Jed0vcela/OPL-synth/schematics, board/opl3 synth EAGLE/SVCSYNTH00.csv

Part | Value | Device | Package | Description | ARROW_PART_NUMBER | ARROW_PRICE-STOCK | DESCRIPTION | HEIGHT | MANUFACTURER_NAME | MANUFACTURER_PART_NUMBER | MF | MOUSER_PART_NUMBER | MOUSER_PRICE-STOCK | MPN | OC_FARNELL | OC_NEWARK | POPULARITY | SPICEPREFIX
A1 | PICO | PICO | PICO | RP2040 microcontroller chip designed by Raspberry Pi in the United Kingdom 2 SPI, 2 I2C, 2 UART, 3 12-bit ADC, 16 controllable PWM channels |  |  | RP2040 microcontroller chip designed by Raspberry Pi in the United Kingdom 2 SPI, 2 I2C, 2 UART, 3 12-bit ADC, 16 controllable PWM channels | 1mm | RASPBERRY-PI | PICO
A2 | 74LS14D | 74LS14D | SO14 | Hex schmitt trigger INVERTER |  |  |  |  |  |  |  |  |  |  |  |  | 3
A3 | 7805DT | 7805DT | TO252 | Positive VOLTAGE REGULATOR |  |  |  |  |  |  |  |  |  |  |  |  | 0
A4 | 74LS14D | 74LS14D | SO14 | Hex schmitt trigger INVERTER |  |  |  |  |  |  |  |  |  |  |  |  | 3
A5 | 74LS14D | 74LS14D | SO14 | Hex schmitt trigger INVERTER |  |  |  |  |  |  |  |  |  |  |  |  | 3
A6 | 74HC595D | 74HC595D | SO16 | 8-bit SHIFT REGISTER, output latch |  |  |  |  |  |  |  |  |  |  |  |  | 21
A7 | YMF262-M | YMF262-M | SOIC127P1180X250-24N | SOUND GENERATOR CIRCUIT, 24 Pin, SOP |  |  | SOUND GENERATOR CIRCUIT, 24 Pin, SOP | 2.5mm | Yamaha | YMF262-M
A8 | YAC512-M | YAC512-M | SOIC127P780X230-16N | Digital Analog Converter, Single, 16 Bit, 16 Pin, SOP |  |  | Digital Analog Converter, Single, 16 Bit, 16 Pin, SOP | 2.3mm | Yamaha | YAC512-M
A9 | YAC512-M | YAC512-M | SOIC127P780X230-16N | Digital Analog Converter, Single, 16 Bit, 16 Pin, SOP |  |  | Digital Analog Converter, Single, 16 Bit, 16 Pin, SOP | 2.3mm | Yamaha | YAC512-M
A10 | RC4580 | LM1458D | SO08 | OP AMP |  |  |  |  |  |  |  |  |  |  |  |  | 1
A11 | RC4580 | LM1458D | SO08 | OP AMP |  |  |  |  |  |  |  |  |  |  |  |  | 1
A12 | RC4580 | LM1458D | SO08 | OP AMP |  |  |  |  |  |  |  |  |  |  |  |  | 1
A13 | RC4580 | LM1458D | SO08 | OP AMP |  |  |  |  |  |  |  |  |  |  |  |  | 1
A14 | 74HC595D | 74HC595D | SO16 | 8-bit SHIFT REGISTER, output latch |  |  |  |  |  |  |  |  |  |  |  |  | 21
A15 | YMF262-M | YMF262-M | SOIC127P1180X250-24N | SOUND GENERATOR CIRCUIT, 24 Pin, SOP |  |  | SOUND GENERATOR CIRCUIT, 24 Pin, SOP | 2.5mm | Yamaha | YMF262-M
A16 | YAC512-M | YAC512-M | SOIC127P780X230-16N | Digital Analog Converter, Single, 16 Bit, 16 Pin, SOP |  |  | Digital Analog Converter, Single, 16 Bit, 16 Pin, SOP | 2.3mm | Yamaha | YAC512-M
A17 | YAC512-M | YAC512-M | SOIC127P780X230-16N | Digital Analog Converter, Single, 16 Bit, 16 Pin, SOP |  |  | Digital Analog Converter, Single, 16 Bit, 16 Pin, SOP | 2.3mm | Yamaha | YAC512-M
A18 | RC4580 | LM1458D | SO08 | OP AMP |  |  |  |  |  |  |  |  |  |  |  |  | 1
A19 | RC4580 | LM1458D | SO08 | OP AMP |  |  |  |  |  |  |  |  |  |  |  |  | 1
A20 | RC4580 | LM1458D | SO08 | OP AMP |  |  |  |  |  |  |  |  |  |  |  |  | 1
A21 | RC4580 | LM1458D | SO08 | OP AMP |  |  |  |  |  |  |  |  |  |  |  |  | 1
A22 | LM1458D | LM1458D | SO08 | OP AMP |  |  |  |  |  |  |  |  |  |  |  |  | 1
A23 | 74LS165D | 74LS165D | SO16 | 8-bit parallel load SHIFT REGISTER |  |  |  |  |  |  |  |  |  |  |  |  | 3
A24 | 74LS165D | 74LS165D | SO16 | 8-bit parallel load SHIFT REGISTER |  |  |  |  |  |  |  |  |  |  |  |  | 3
A25 | 4051D | 4051D | SO16 | 8-channel ANALOG MULTIPLEXER |  |  |  |  |  |  |  |  |  |  |  |  | 5
A26 | 4051D | 4051D | SO16 | 8-channel ANALOG MULTIPLEXER |  |  |  |  |  |  |  |  |  |  |  |  | 5
A27 | 4051D | 4051D | SO16 | 8-channel ANALOG MULTIPLEXER |  |  |  |  |  |  |  |  |  |  |  |  | 5
A28 | LM2903D | LM2903D | SO08 | COMPARATOR |  |  |  |  |  |  |  |  |  |  |  |  | 0
A29 | 74AHC1G14DBV | 74AHC1G14DBV | SOT23-5 | Single Schmitt-Trigger Inverter Gate
C1 | 2n7 | C0805 | R0805 | SMD Sizes:
C2 | 2n7 | C0805 | R0805 | SMD Sizes:
C3 | 2n7 | C0805 | R0805 | SMD Sizes:
C4 | 2n7 | C0805 | R0805 | SMD Sizes:
C5 | 2n7 | C0805 | R0805 | SMD Sizes:
C6 | 2n7 | C0805 | R0805 | SMD Sizes:
C7 | 2n7 | C0805 | R0805 | SMD Sizes:
C8 | 2n7 | C0805 | R0805 | SMD Sizes:
C9 | 2n7 | C0805 | R0805 | SMD Sizes:
C10 | 2n7 | C0805 | R0805 | SMD Sizes:
C11 | 2n7 | C0805 | R0805 | SMD Sizes:
C12 | 2n7 | C0805 | R0805 | SMD Sizes:
C13 | 2n7 | C0805 | R0805 | SMD Sizes:
C14 | 2n7 | C0805 | R0805 | SMD Sizes:
C15 | 2n7 | C0805 | R0805 | SMD Sizes:
C16 | 2n7 | C0805 | R0805 | SMD Sizes:
C17 | 100n | C0805 | R0805 | SMD Sizes:
C18 | 100n | C0805 | R0805 | SMD Sizes:
C19 | 100n | C0805 | R0805 | SMD Sizes:
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
L8 |  | LED3MM | LED3MM | LED
L9 |  | LED3MM | LED3MM | LED
L10 |  | LED3MM | LED3MM | LED
L11 |  | LED3MM | LED3MM | LED
L12 |  | LED3MM | LED3MM | LED
M1 | MIDIJACK | MIDIJACK | CP-2350 | DIN 5 jack also known as MIDI jack
M2 | MIDIJACK | MIDIJACK | CP-2350 | DIN 5 jack also known as MIDI jack
OK1 | PC817 | PC817 | DIL04 | SHARP OPTO COUPLER |  |  |  |  |  |  |  |  |  | PC817X4J000F | 9707727 | 97K7059 | 20
P1 | 10k | TRIM_EU-CA6V | CA6V | POTENTIOMETER |  |  |  |  |  |  |  |  |  |  |  |  | 10
P2 | 10k | TRIM_EU-CA6V | CA6V | POTENTIOMETER |  |  |  |  |  |  |  |  |  |  |  |  | 10
P3 | 10k | TRIM_EU-CA6V | CA6V | POTENTIOMETER |  |  |  |  |  |  |  |  |  |  |  |  | 10
P4 | 10k | TRIM_EU-CA6V | CA6V | POTENTIOMETER |  |  |  |  |  |  |  |  |  |  |  |  | 10
P6 | 10k | TRIM_EU-CA6V | CA6V | POTENTIOMETER |  |  |  |  |  |  |  |  |  |  |  |  | 10
P8 | 10k | TRIM_EU-CA6V | CA6V | POTENTIOMETER |  |  |  |  |  |  |  |  |  |  |  |  | 10
P10 | 10k | TRIM_EU-CA6V | CA6V | POTENTIOMETER |  |  |  |  |  |  |  |  |  |  |  |  | 10
Q1 | TEFT4300 | TEFT4300 | TEFT4300 | Vishay TEFT4300 60 Infrared Phototransistor, Through-hole 3mm Package | TEFT4300 | https://www.arrow.com/en/products/teft4300/vishay?region=nac | Vishay TEFT4300 60 Infrared Phototransistor, Through-hole 3mm Package | 6.1mm | Vishay | TEFT4300 |  | 782-TEFT4300 | https://www.mouser.co.uk/ProductDetail/Vishay-Semiconductors/TEFT4300?qs=HsFHTXumnCRbcrt8oPFPMA%3D%3D
Q2 | TEFT4300 | TEFT4300 | TEFT4300 | Vishay TEFT4300 60 Infrared Phototransistor, Through-hole 3mm Package | TEFT4300 | https://www.arrow.com/en/products/teft4300/vishay?region=nac | Vishay TEFT4300 60 Infrared Phototransistor, Through-hole 3mm Package | 6.1mm | Vishay | TEFT4300 |  | 782-TEFT4300 | https://www.mouser.co.uk/ProductDetail/Vishay-Semiconductors/TEFT4300?qs=HsFHTXumnCRbcrt8oPFPMA%3D%3D
Q3 | TEFT4300 | TEFT4300 | TEFT4300 | Vishay TEFT4300 60 Infrared Phototransistor, Through-hole 3mm Package | TEFT4300 | https://www.arrow.com/en/products/teft4300/vishay?region=nac | Vishay TEFT4300 60 Infrared Phototransistor, Through-hole 3mm Package | 6.1mm | Vishay | TEFT4300 |  | 782-TEFT4300 | https://www.mouser.co.uk/ProductDetail/Vishay-Semiconductors/TEFT4300?qs=HsFHTXumnCRbcrt8oPFPMA%3D%3D
Q4 | TEFT4300 | TEFT4300 | TEFT4300 | Vishay TEFT4300 60 Infrared Phototransistor, Through-hole 3mm Package | TEFT4300 | https://www.arrow.com/en/products/teft4300/vishay?region=nac | Vishay TEFT4300 60 Infrared Phototransistor, Through-hole 3mm Package | 6.1mm | Vishay | TEFT4300 |  | 782-TEFT4300 | https://www.mouser.co.uk/ProductDetail/Vishay-Semiconductors/TEFT4300?qs=HsFHTXumnCRbcrt8oPFPMA%3D%3D
Q5 | TEFT4300 | TEFT4300 | TEFT4300 | Vishay TEFT4300 60 Infrared Phototransistor, Through-hole 3mm Package | TEFT4300 | https://www.arrow.com/en/products/teft4300/vishay?region=nac | Vishay TEFT4300 60 Infrared Phototransistor, Through-hole 3mm Package | 6.1mm | Vishay | TEFT4300 |  | 782-TEFT4300 | https://www.mouser.co.uk/ProductDetail/Vishay-Semiconductors/TEFT4300?qs=HsFHTXumnCRbcrt8oPFPMA%3D%3D
Q6 | TEFT4300 | TEFT4300 | TEFT4300 | Vishay TEFT4300 60 Infrared Phototransistor, Through-hole 3mm Package | TEFT4300 | https://www.arrow.com/en/products/teft4300/vishay?region=nac | Vishay TEFT4300 60 Infrared Phototransistor, Through-hole 3mm Package | 6.1mm | Vishay | TEFT4300 |  | 782-TEFT4300 | https://www.mouser.co.uk/ProductDetail/Vishay-Semiconductors/TEFT4300?qs=HsFHTXumnCRbcrt8oPFPMA%3D%3D
Q7 | TEFT4300 | TEFT4300 | TEFT4300 | Vishay TEFT4300 60 Infrared Phototransistor, Through-hole 3mm Package | TEFT4300 | https://www.arrow.com/en/products/teft4300/vishay?region=nac | Vishay TEFT4300 60 Infrared Phototransistor, Through-hole 3mm Package | 6.1mm | Vishay | TEFT4300 |  | 782-TEFT4300 | https://www.mouser.co.uk/ProductDetail/Vishay-Semiconductors/TEFT4300?qs=HsFHTXumnCRbcrt8oPFPMA%3D%3D
Q8 | TEFT4300 | TEFT4300 | TEFT4300 | Vishay TEFT4300 60 Infrared Phototransistor, Through-hole 3mm Package | TEFT4300 | https://www.arrow.com/en/products/teft4300/vishay?region=nac | Vishay TEFT4300 60 Infrared Phototransistor, Through-hole 3mm Package | 6.1mm | Vishay | TEFT4300 |  | 782-TEFT4300 | https://www.mouser.co.uk/ProductDetail/Vishay-Semiconductors/TEFT4300?qs=HsFHTXumnCRbcrt8oPFPMA%3D%3D
Q9 | TEFT4300 | TEFT4300 | TEFT4300 | Vishay TEFT4300 60 Infrared Phototransistor, Through-hole 3mm Package | TEFT4300 | https://www.arrow.com/en/products/teft4300/vishay?region=nac | Vishay TEFT4300 60 Infrared Phototransistor, Through-hole 3mm Package | 6.1mm | Vishay | TEFT4300 |  | 782-TEFT4300 | https://www.mouser.co.uk/ProductDetail/Vishay-Semiconductors/TEFT4300?qs=HsFHTXumnCRbcrt8oPFPMA%3D%3D
Q10 | TEFT4300 | TEFT4300 | TEFT4300 | Vishay TEFT4300 60 Infrared Phototransistor, Through-hole 3mm Package | TEFT4300 | https://www.arrow.com/en/products/teft4300/vishay?region=nac | Vishay TEFT4300 60 Infrared Phototransistor, Through-hole 3mm Package | 6.1mm | Vishay | TEFT4300 |  | 782-TEFT4300 | https://www.mouser.co.uk/ProductDetail/Vishay-Semiconductors/TEFT4300?qs=HsFHTXumnCRbcrt8oPFPMA%3D%3D
Q11 | TEFT4300 | TEFT4300 | TEFT4300 | Vishay TEFT4300 60 Infrared Phototransistor, Through-hole 3mm Package | TEFT4300 | https://www.arrow.com/en/products/teft4300/vishay?region=nac | Vishay TEFT4300 60 Infrared Phototransistor, Through-hole 3mm Package | 6.1mm | Vishay | TEFT4300 |  | 782-TEFT4300 | https://www.mouser.co.uk/ProductDetail/Vishay-Semiconductors/TEFT4300?qs=HsFHTXumnCRbcrt8oPFPMA%3D%3D
Q12 | TEFT4300 | TEFT4300 | TEFT4300 | Vishay TEFT4300 60 Infrared Phototransistor, Through-hole 3mm Package | TEFT4300 | https://www.arrow.com/en/products/teft4300/vishay?region=nac | Vishay TEFT4300 60 Infrared Phototransistor, Through-hole 3mm Package | 6.1mm | Vishay | TEFT4300 |  | 782-TEFT4300 | https://www.mouser.co.uk/ProductDetail/Vishay-Semiconductors/TEFT4300?qs=HsFHTXumnCRbcrt8oPFPMA%3D%3D
Q13 | 14.31818M-SMDHC49S | CSM-7X-DU | CSM-7X-DU | SMD CRYSTAL |  |  |  |  |  |  |  |  |  |  | unknown | unknown | 3
R1 | 10k | R0805 | R0805 | Resistor vcetne SMD
R2 | 10k | R0805 | R0805 | Resistor vcetne SMD
R3 | 10k | R0805 | R0805 | Resistor vcetne SMD
R4 | 10k | R0805 | R0805 | Resistor vcetne SMD
R5 | 10k | R0805 | R0805 | Resistor vcetne SMD
R6 | 10k | R0805 | R0805 | Resistor vcetne SMD
R7 | 10k | R0805 | R0805 | Resistor vcetne SMD
R8 | 10k | R0805 | R0805 | Resistor vcetne SMD
R9 | 10k | R0805 | R0805 | Resistor vcetne SMD
R10 | 10k | R0805 | R0805 | Resistor vcetne SMD
R11 | 10k | R0805 | R0805 | Resistor vcetne SMD
R12 | 10k | R0805 | R0805 | Resistor vcetne SMD
R13 | 10k | R0805 | R0805 | Resistor vcetne SMD
R14 | 10k | R0805 | R0805 | Resistor vcetne SMD
R15 | 10k | R0805 | R0805 | Resistor vcetne SMD
R16 | 10k | R0805 | R0805 | Resistor vcetne SMD
R17 | 33 | R0805 | R0805 | Resistor vcetne SMD
R18 | 10k | TRIM_EU-CA6V | CA6V | POTENTIOMETER |  |  |  |  |  |  |  |  |  |  |  |  | 10
R19 | 10k | R0805 | R0805 | Resistor vcetne SMD
R20 | 4k7 | R0805 | R0805 | Resistor vcetne SMD
R21 | 100 | R0805 | R0805 | Resistor vcetne SMD
R22 | 4k7 | R0805 | R0805 | Resistor vcetne SMD
R23 | 100 | R0805 | R0805 | Resistor vcetne SMD
R24 | 10k | R0805 | R0805 | Resistor vcetne SMD
R25 | 10k | TRIM_EU-CA6V | CA6V | POTENTIOMETER |  |  |  |  |  |  |  |  |  |  |  |  | 10
R26 | 4k7 | R0805 | R0805 | Resistor vcetne SMD
R27 | 4k7 | R0805 | R0805 | Resistor vcetne SMD
R28 | 100 | R0805 | R0805 | Resistor vcetne SMD
R29 | 100 | R0805 | R0805 | Resistor vcetne SMD
R30 | 1k | R0805 | R0805 | Resistor vcetne SMD
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
X1 | STEREOJACK | STEREOJACK | STX3100 | MIC/HEADPHONE JACK
