Jed0vcela/OPL-synth/3D models/body v2.STEP

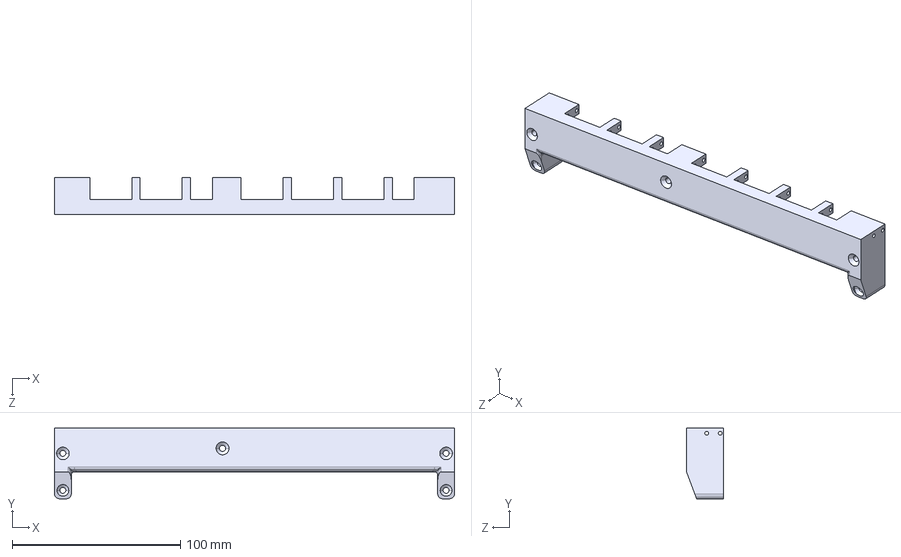
[picture p1: CAD file, 2025-05-17]
3D models/body v2.STEP
238.0 x 42.0 x 22.0 mm
