Jed0vcela/OPL-synth/3D models/white key 2.STEP

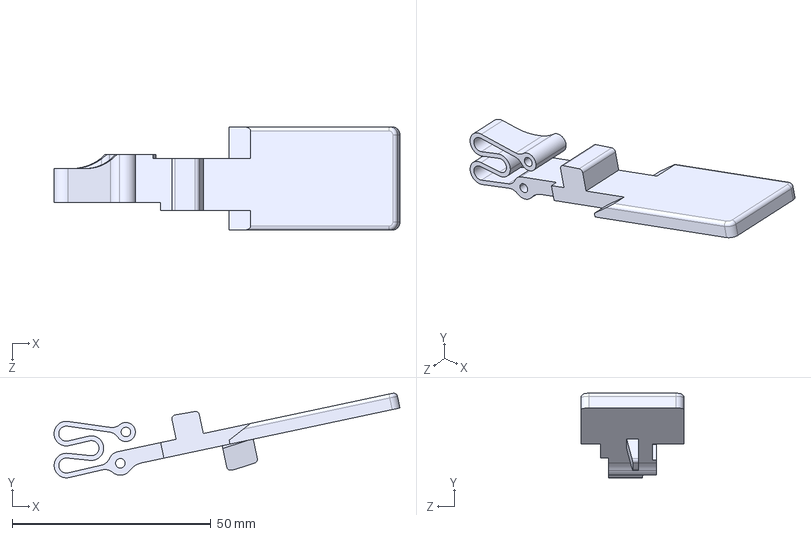
[picture p2: CAD file, 2025-05-17]
3D models/white key 2.STEP
87.1 x 21.3 x 26.0 mm
