Jed0vcela/OPL-synth/3D models/spodni deska v3.STEP

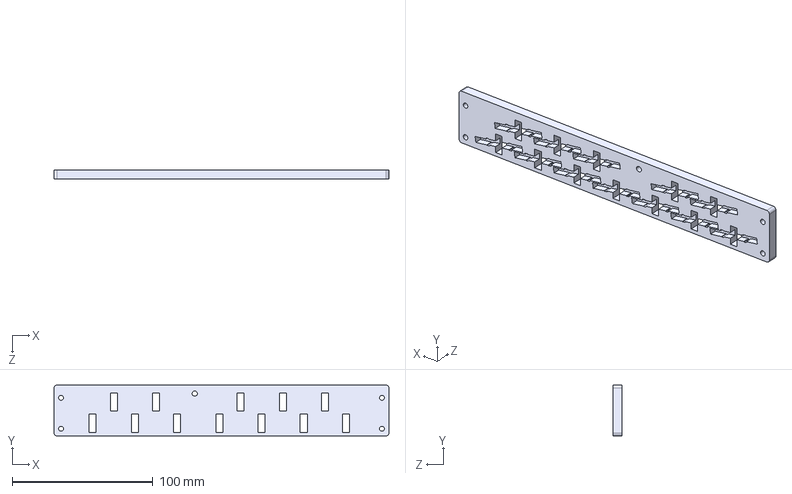
[picture p3: CAD file, 2025-05-17]
3D models/spodni deska v3.STEP
238.0 x 36.0 x 6.50 mm
