Jed0vcela/OPL-synth/3D models/black key 2.STEP

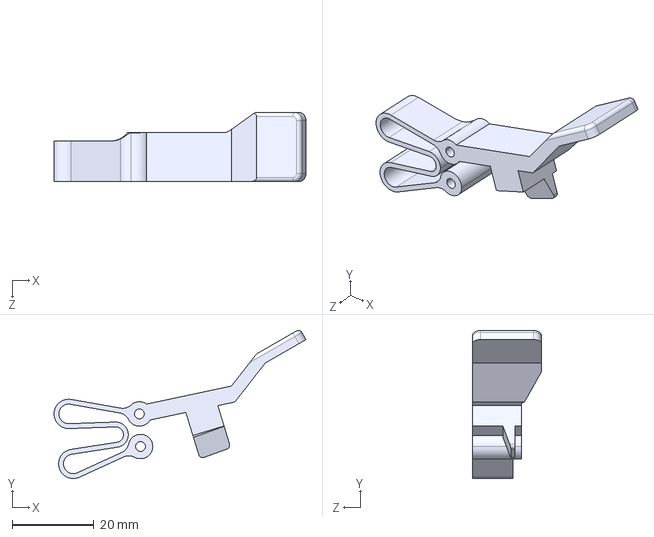
[picture p4: CAD file, 2025-05-17]
3D models/black key 2.STEP
61.8 x 36.3 x 17.0 mm
