Jed0vcela/OPL-synth/(list of files, cad)

Other CAD files:
3D models/black key 2.SLDPRT
3D models/black key 2.STL
3D models/spodni deska v3.STL
3D models/white key 2.SLDPRT
3D models/white key 2.STL
