Jed0vcela/OPL-synth/schematics, board/SVCSYNTH00.pdf

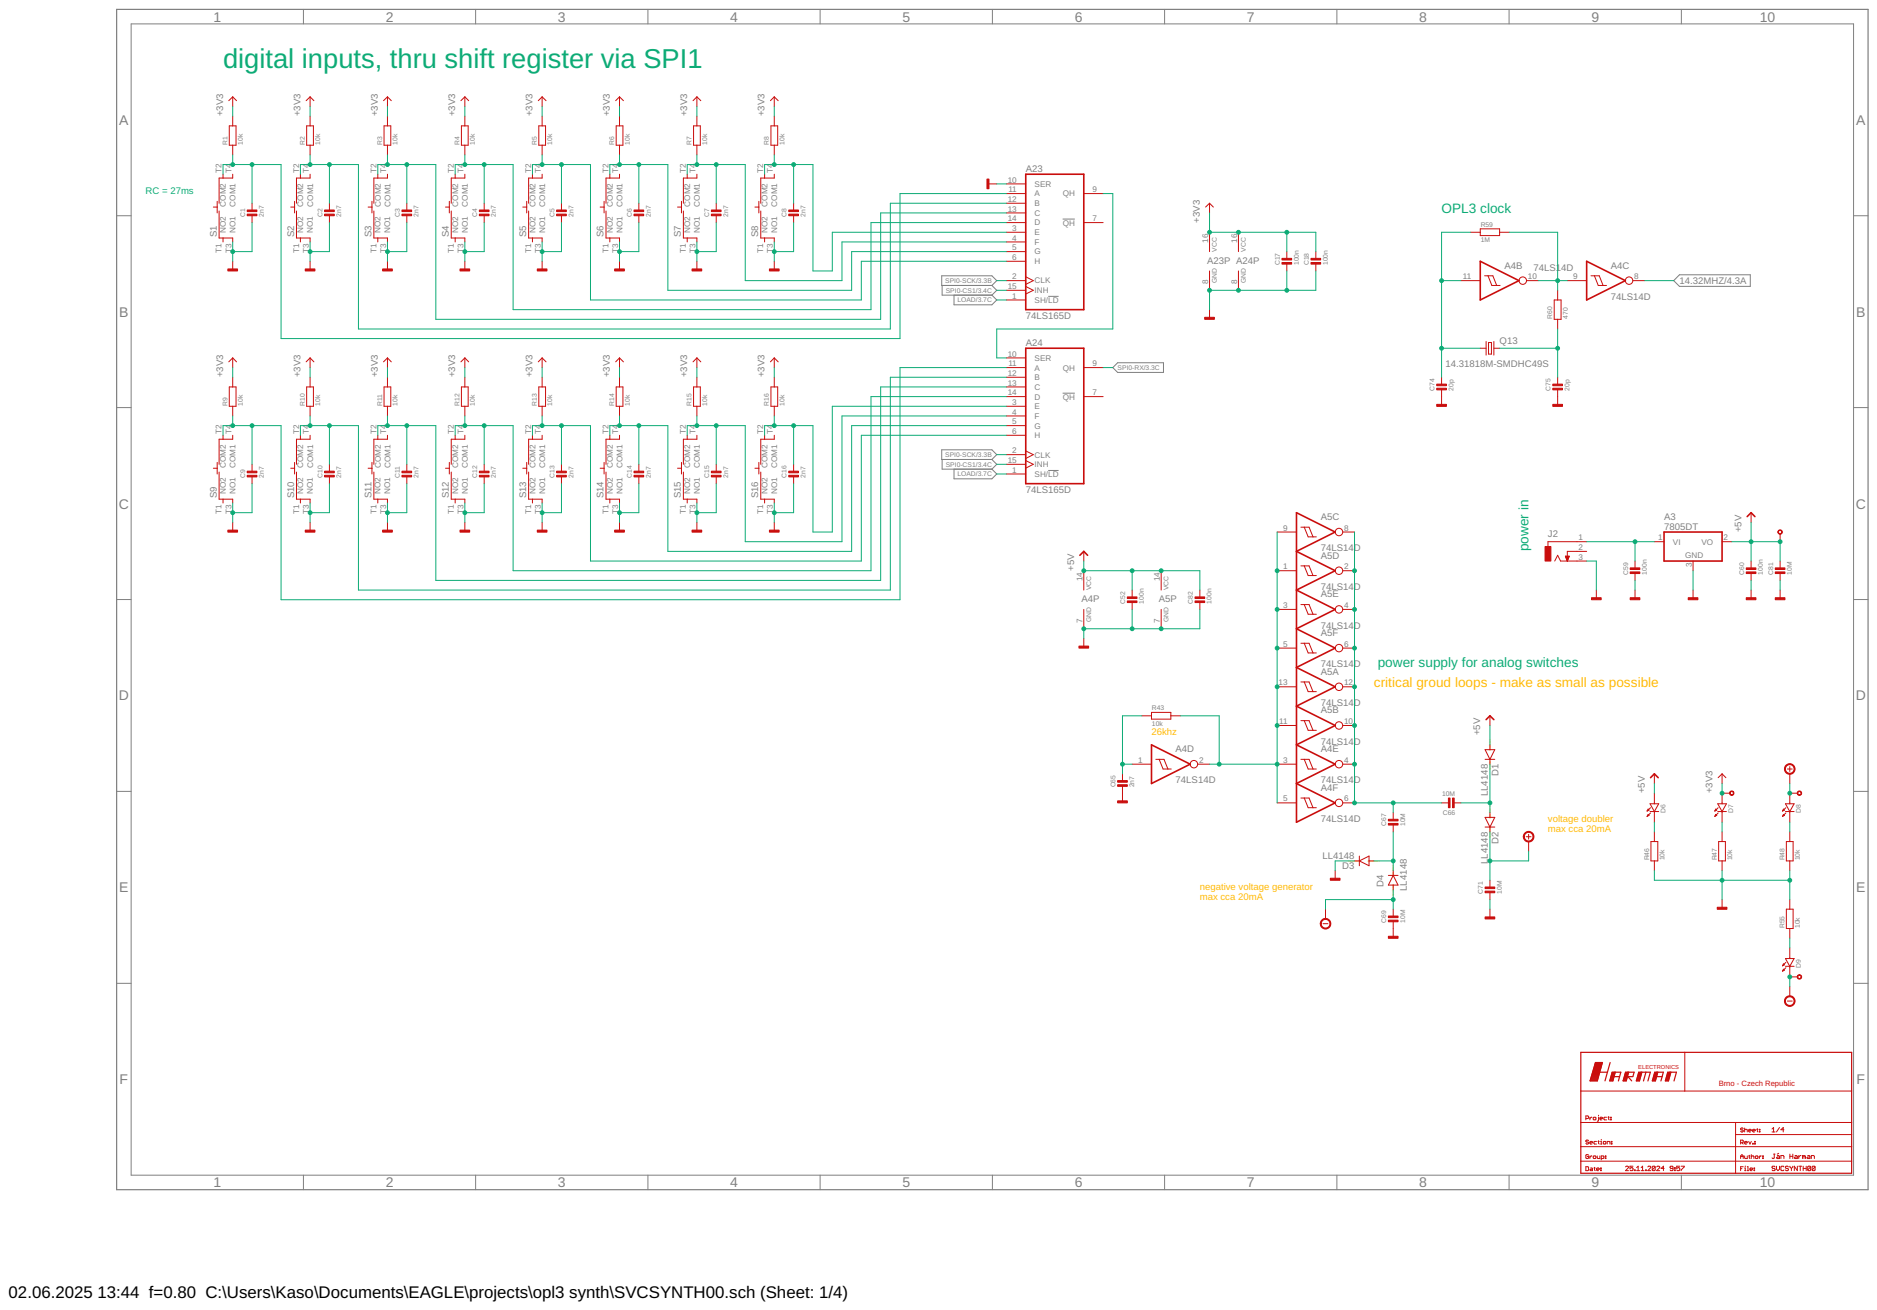
[picture p5: page 1]

digital inputs, thru shift register via SPI1

power supply for analog switches
critical groud loops - make as small as possible

SpiceOrder 1 SpiceOrder 2

negative voltage generator max cca 20mA

Brno - Czech Republic ELECTRONICS

02.06.2025 13:44 f=0.80 C:\Users\Kaso\Documents\EAGLE\projects\opl3 synth\SVCSYNTH00.sch (Sheet: 1/4)

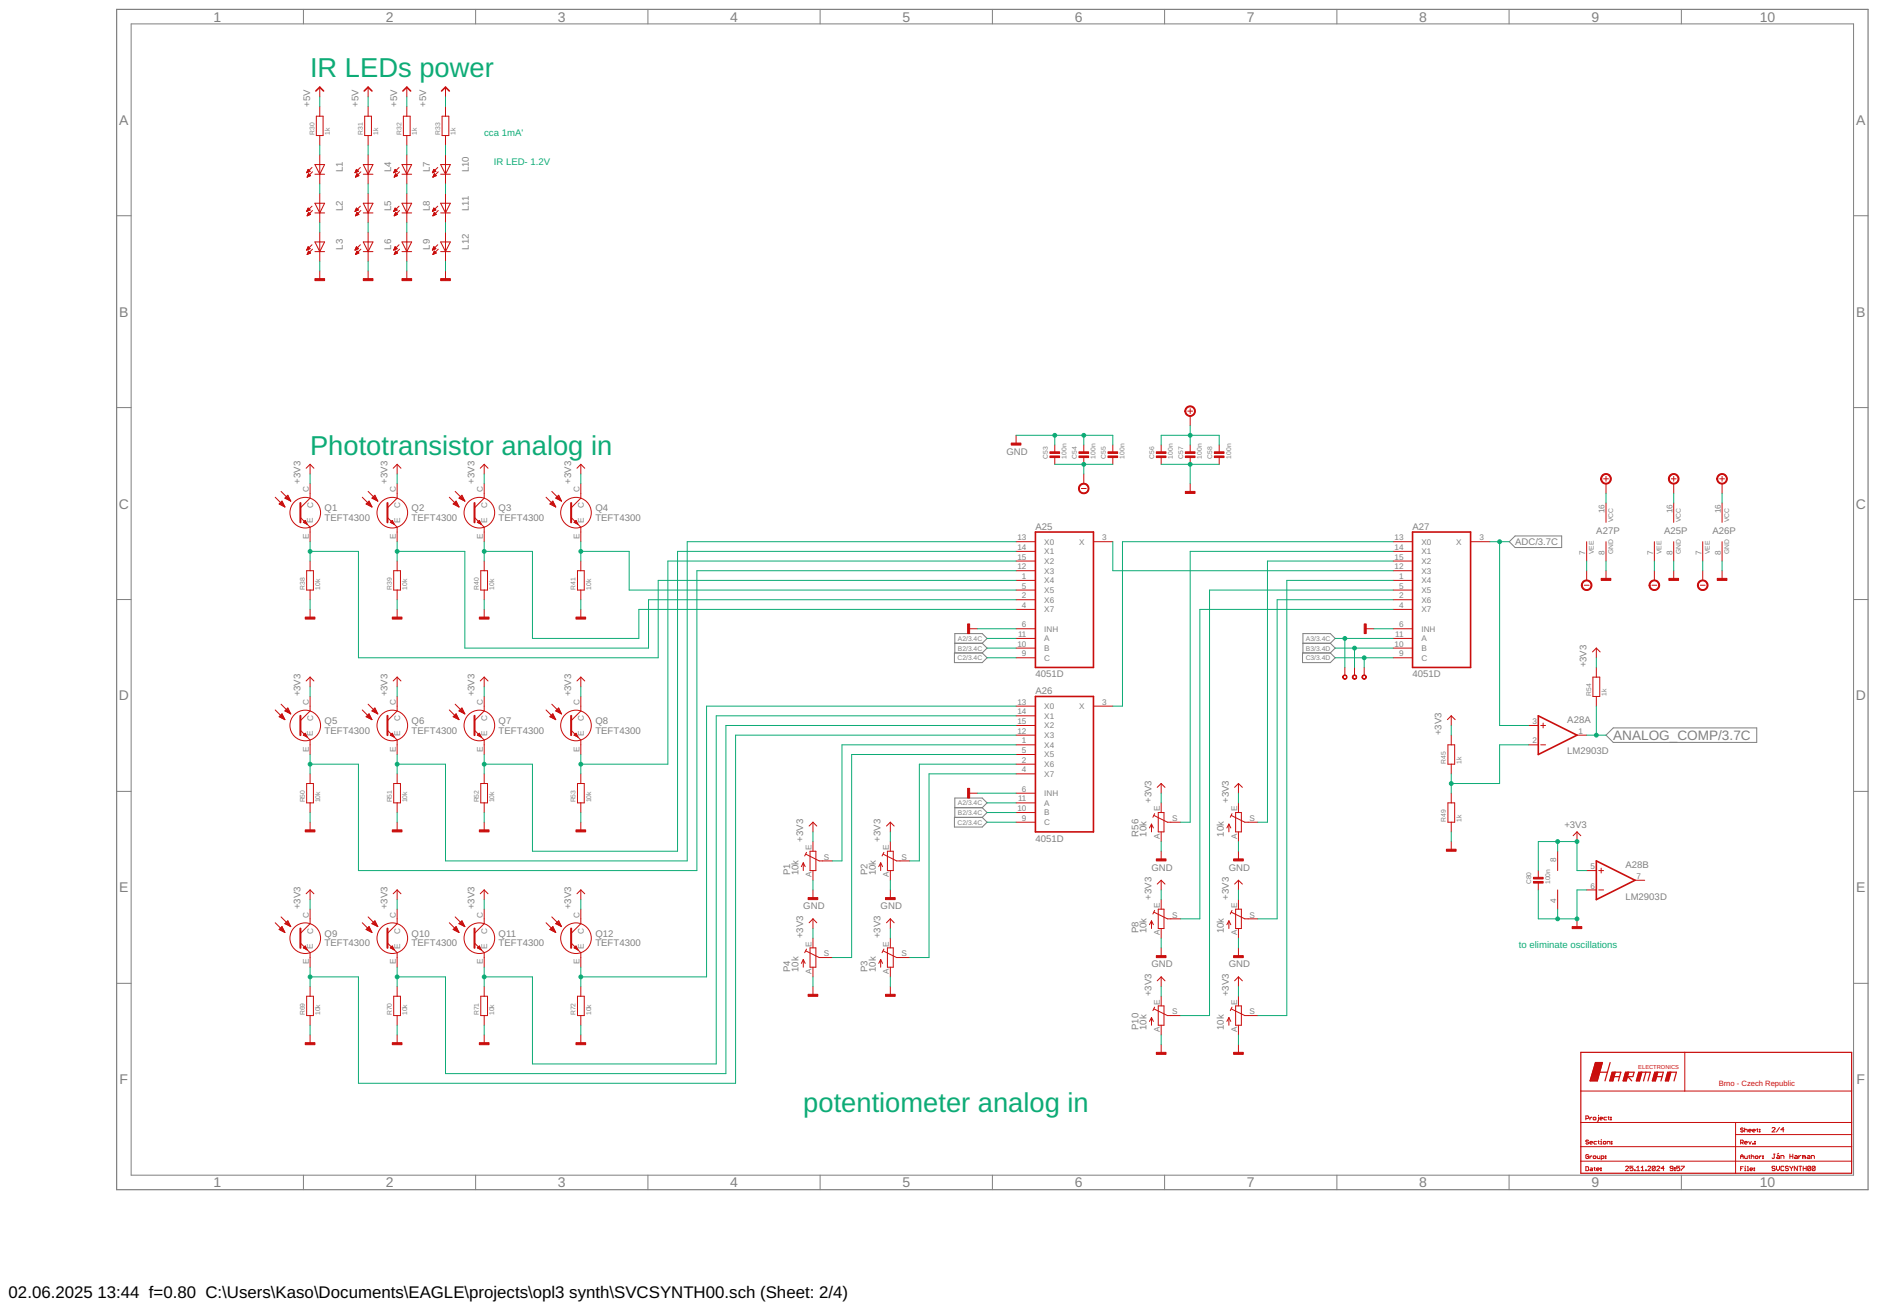
[picture p6: page 2]

cca 1mA' IR LEDs power

Brno - Czech Republic ELECTRONICS

02.06.2025 13:44 f=0.80 C:\Users\Kaso\Documents\EAGLE\projects\opl3 synth\SVCSYNTH00.sch (Sheet: 2/4)

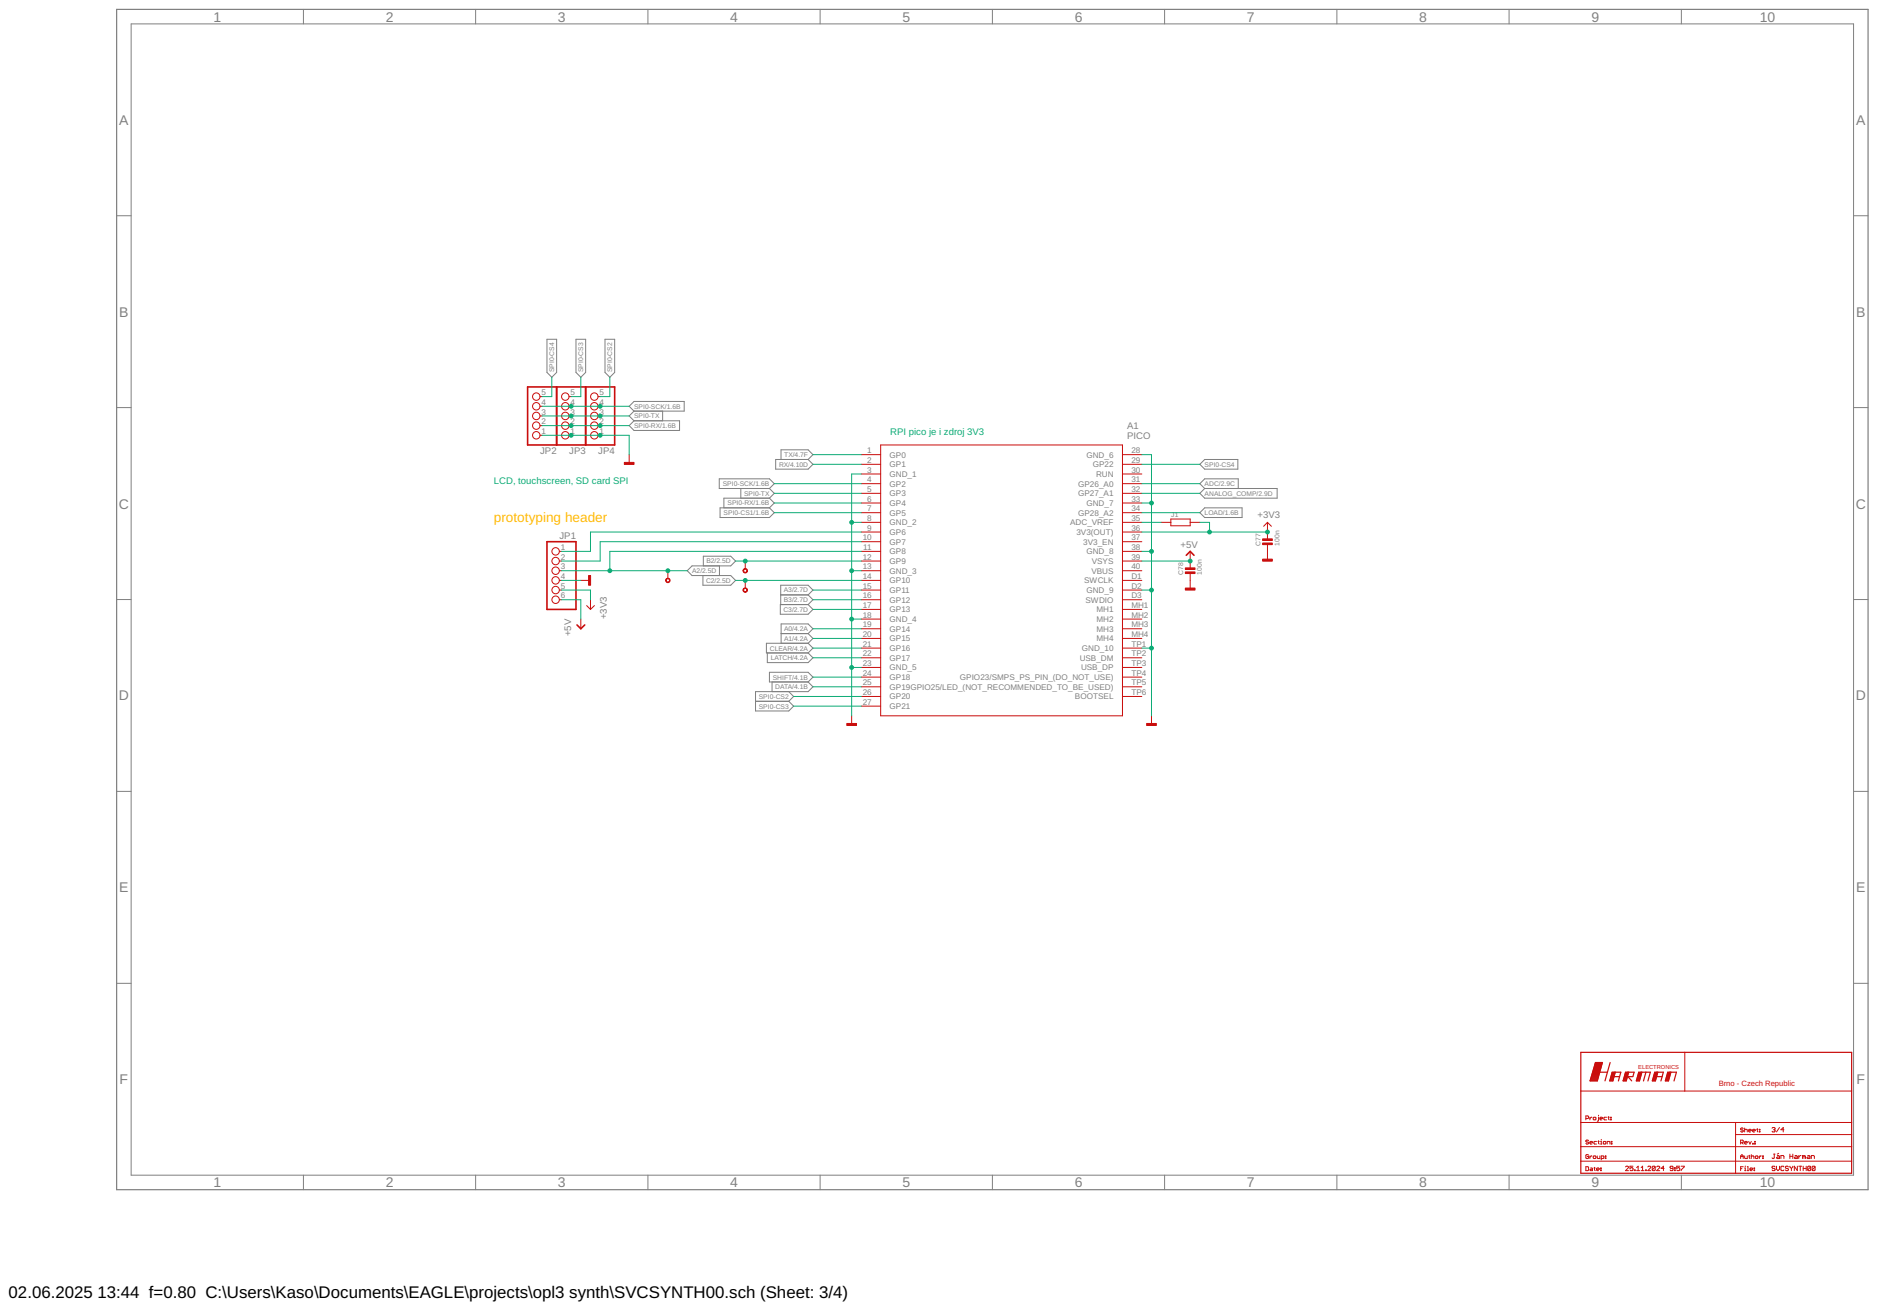
[picture p7: page 3]

Brno - Czech Republic ELECTRONICS

02.06.2025 13:44 f=0.80 C:\Users\Kaso\Documents\EAGLE\projects\opl3 synth\SVCSYNTH00.sch (Sheet: 3/4)

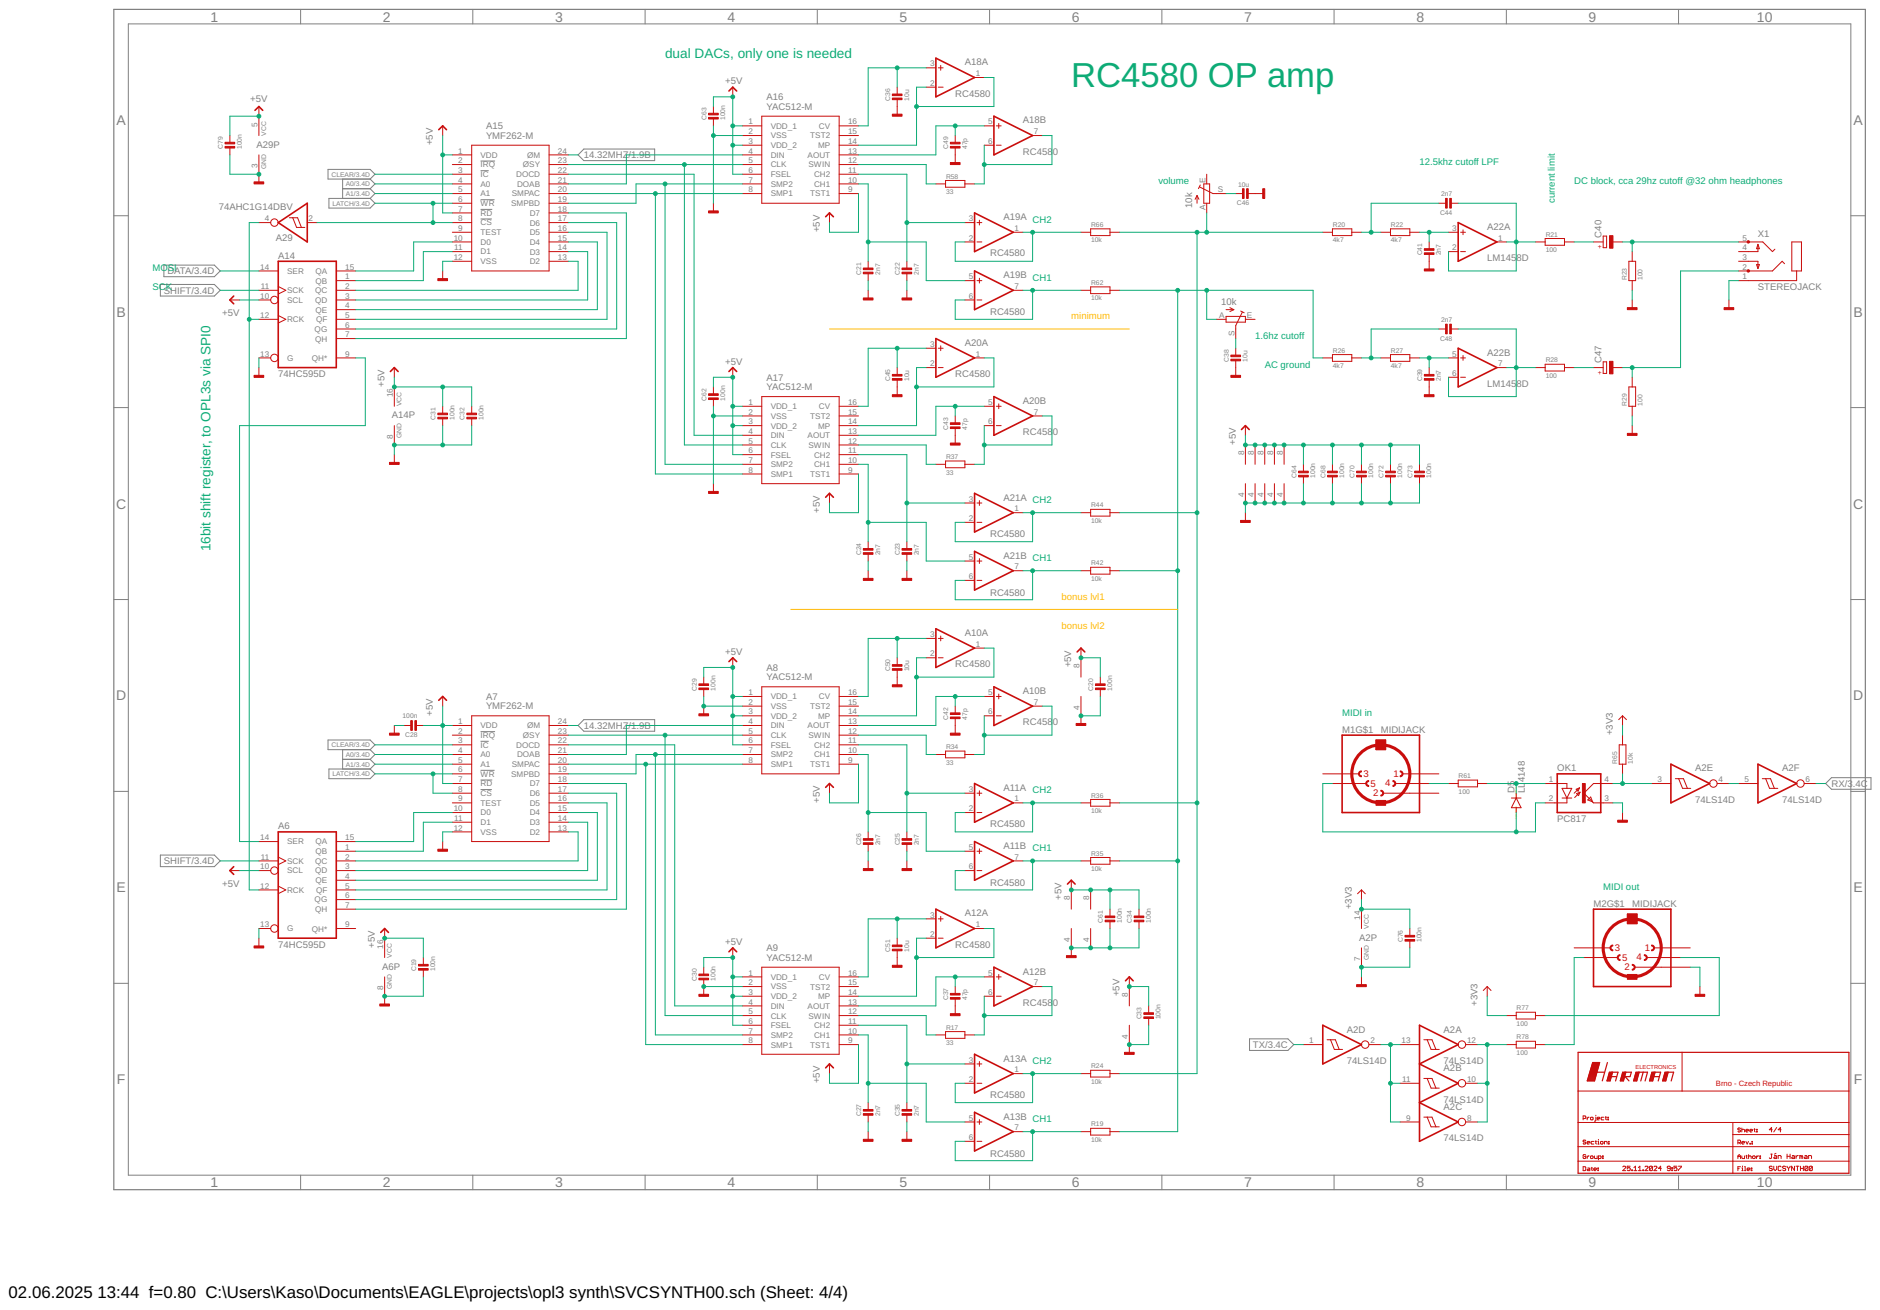
[picture p8: page 4]

dual DACs, only one is needed

12.5khz cutoff LPF RC4580 OP amp

current limit DC block, cca 29hz cutoff @32 ohm headphones

16bit shift register, to OPL3s via SPI0

Brno - Czech Republic ELECTRONICS

02.06.2025 13:44 f=0.80 C:\Users\Kaso\Documents\EAGLE\projects\opl3 synth\SVCSYNTH00.sch (Sheet: 4/4)
