Jed0vcela/OPL-synth/schematics, board/SVCSYNTH001.pdf

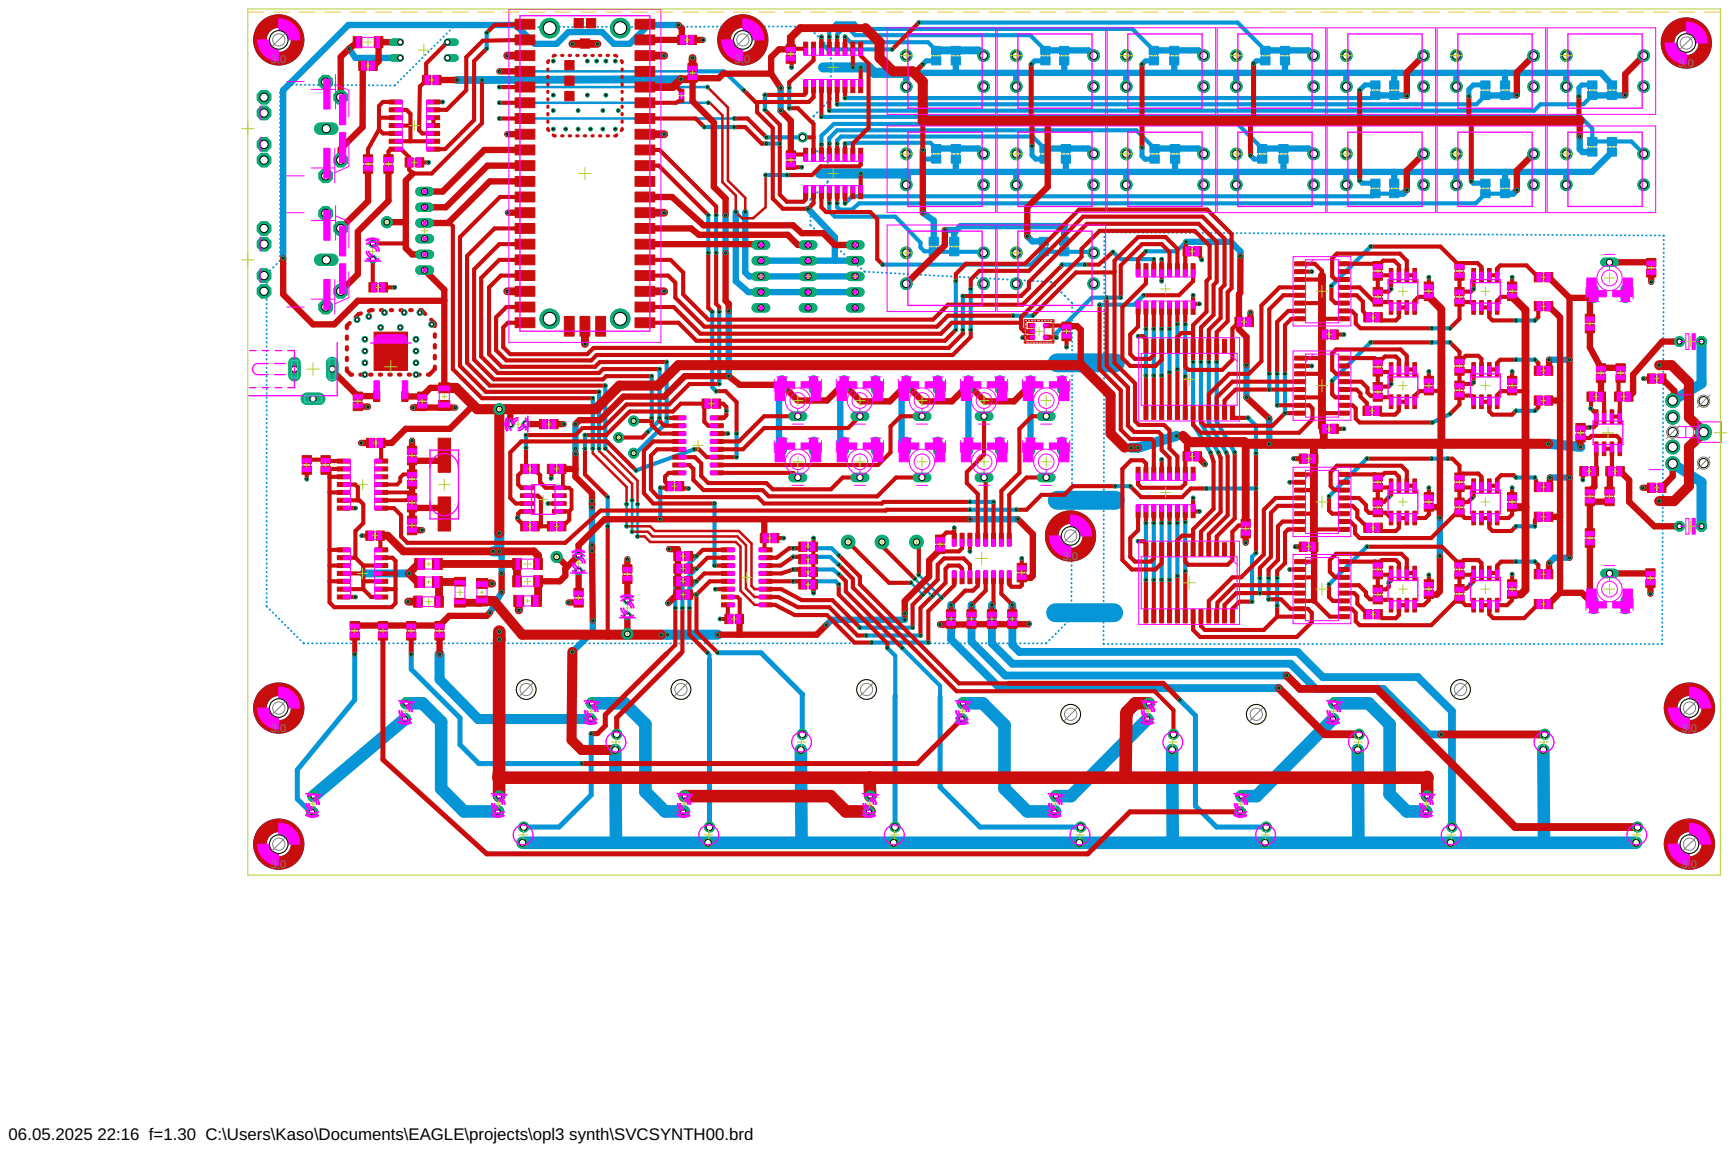
[picture p9: page 1]

06.05.2025 22:16 f=1.30 C:\Users\Kaso\Documents\EAGLE\projects\opl3 synth\SVCSYNTH00.brd
