Jed0vcela/OPL-synth/3D models/SVCSYNTH00.pdf

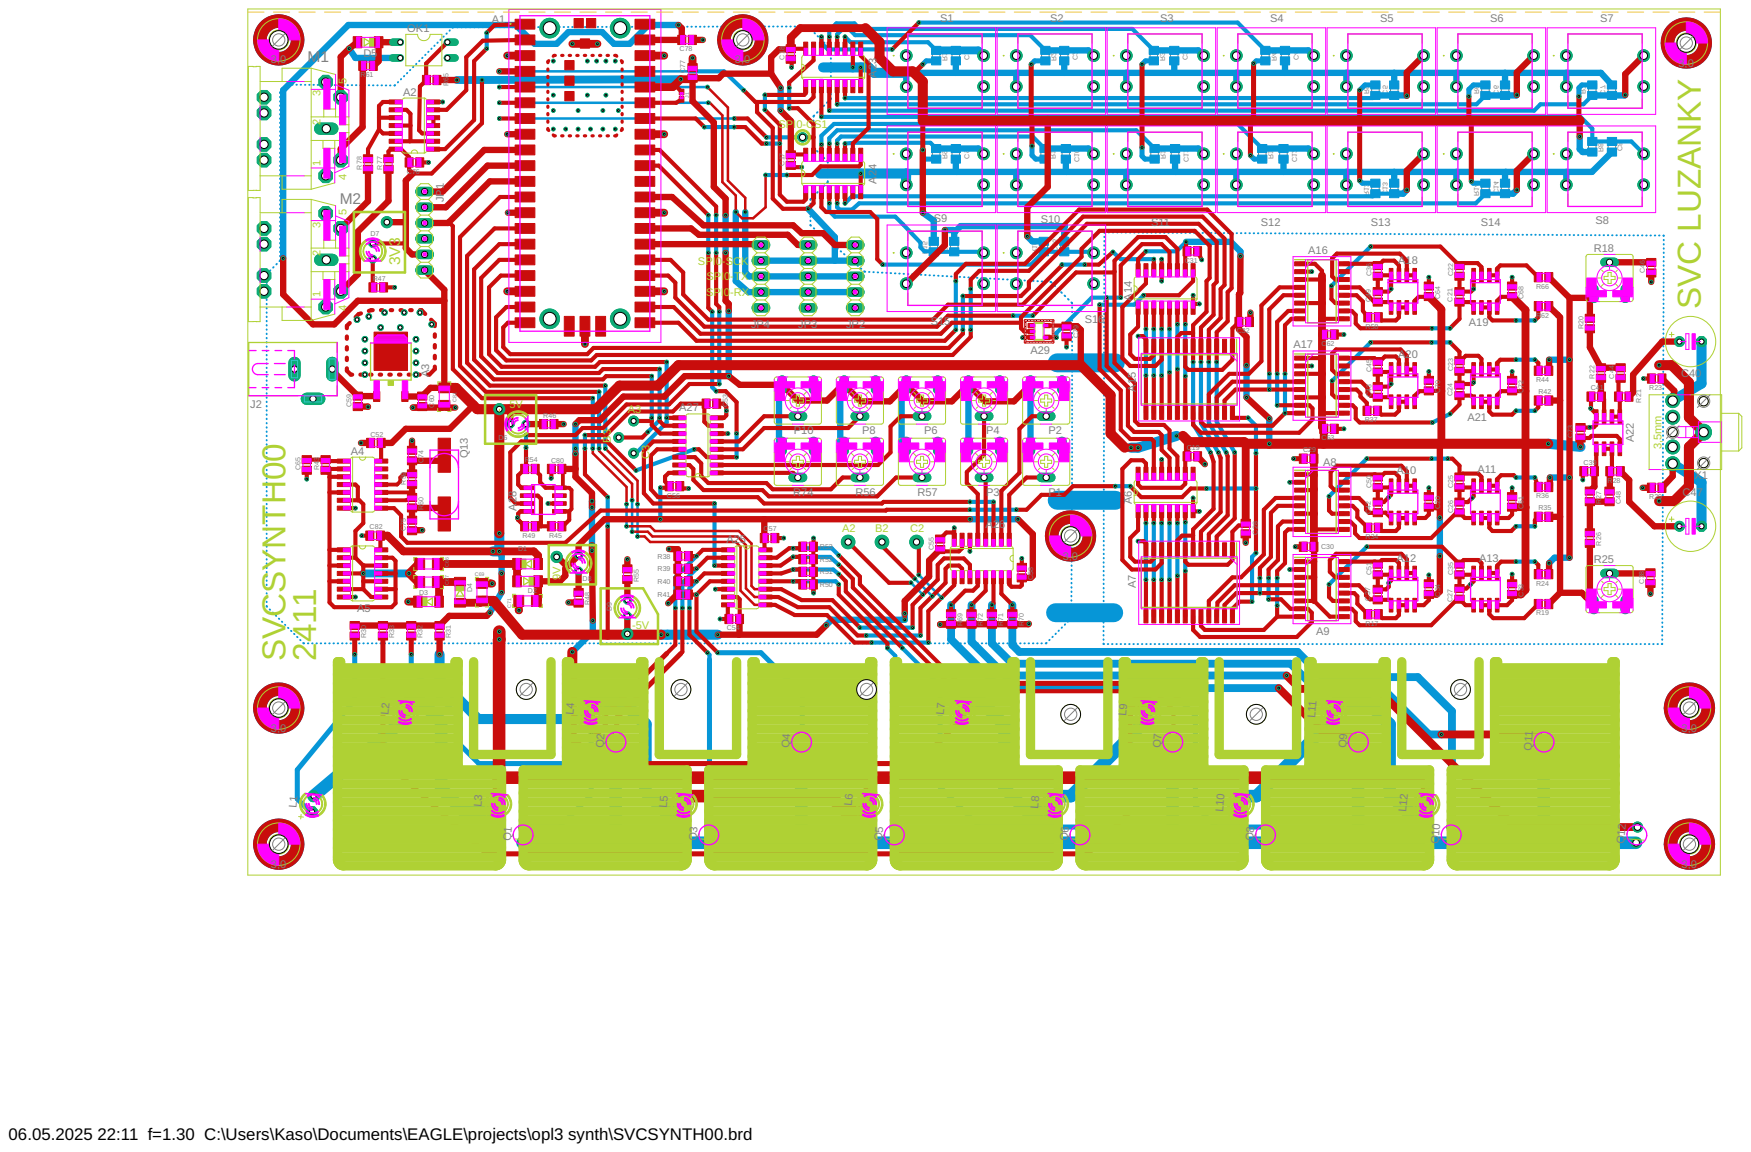
[picture p10: page 1]

06.05.2025 22:11 f=1.30 C:\Users\Kaso\Documents\EAGLE\projects\opl3 synth\SVCSYNTH00.brd
