Jed0vcela/OPL-synth/schematics, board/opl3 synth EAGLE/SVCSYNTH00.brd

## EAGLE design schematics, board/opl3 synth EAGLE/SVCSYNTH00.brd (2025-06-02)

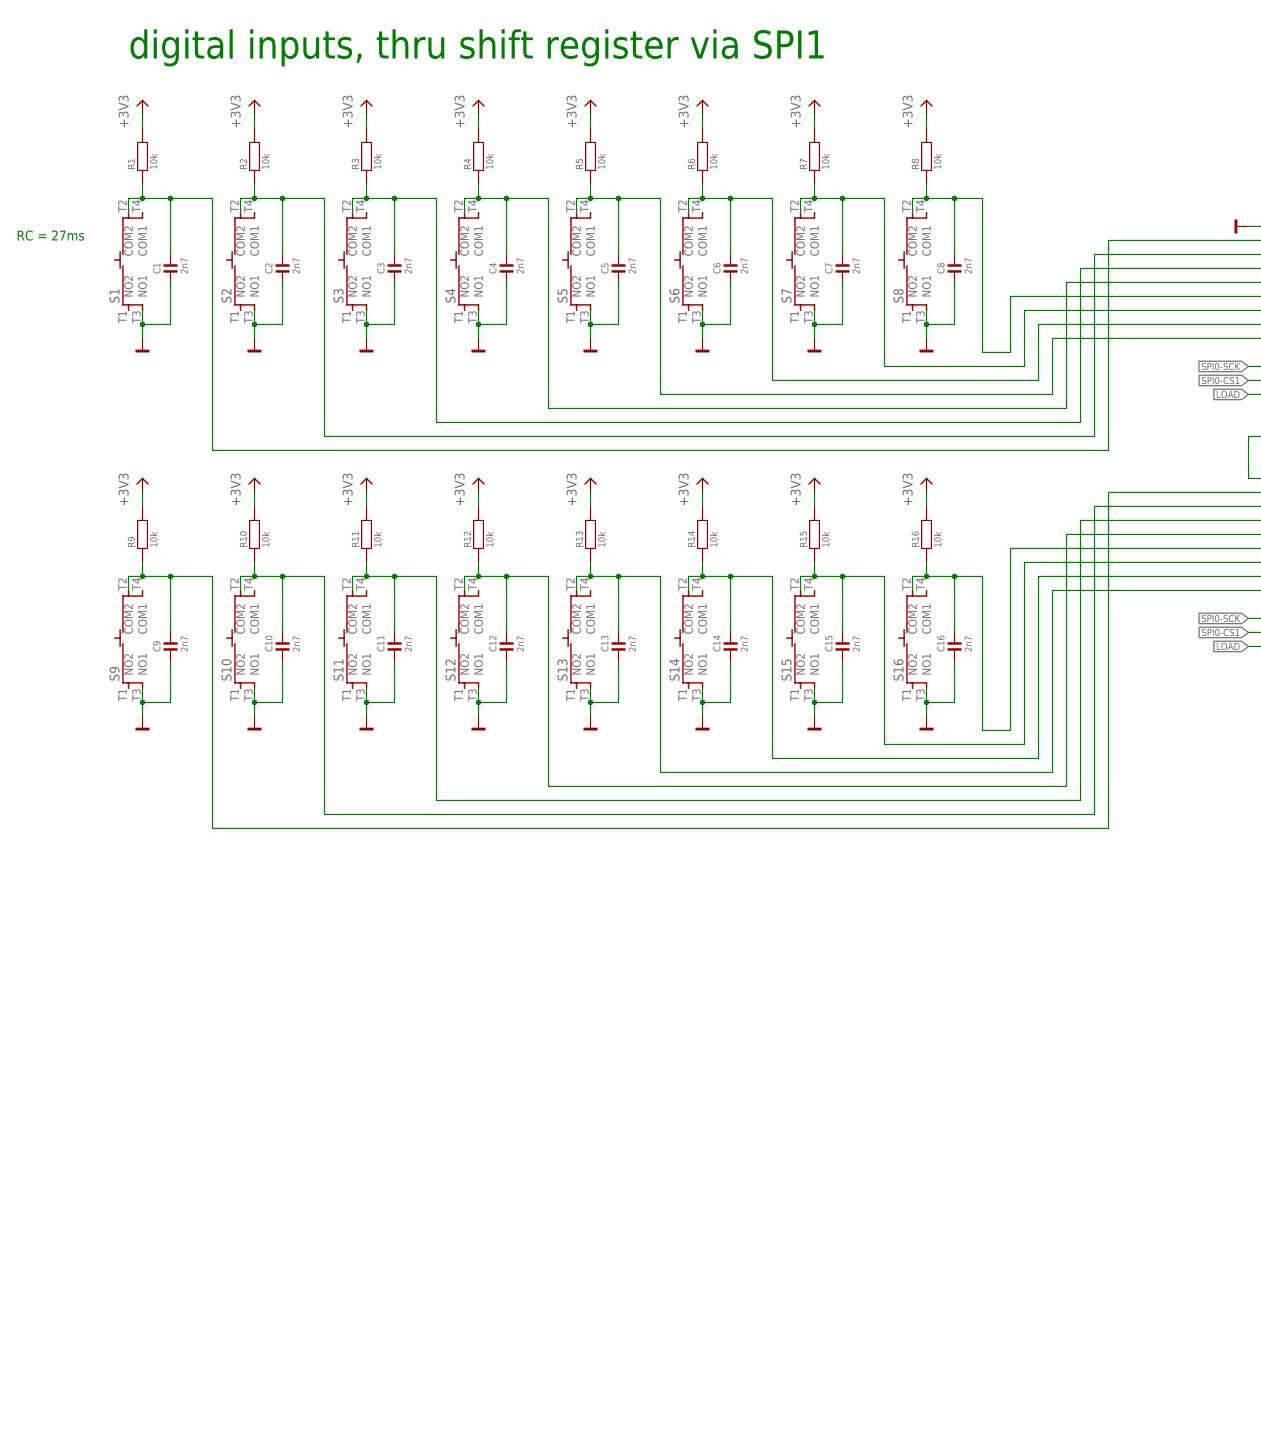
[picture p11: schematic SVCSYNTH00.sch, sheet 1, part in row 1, column 1]

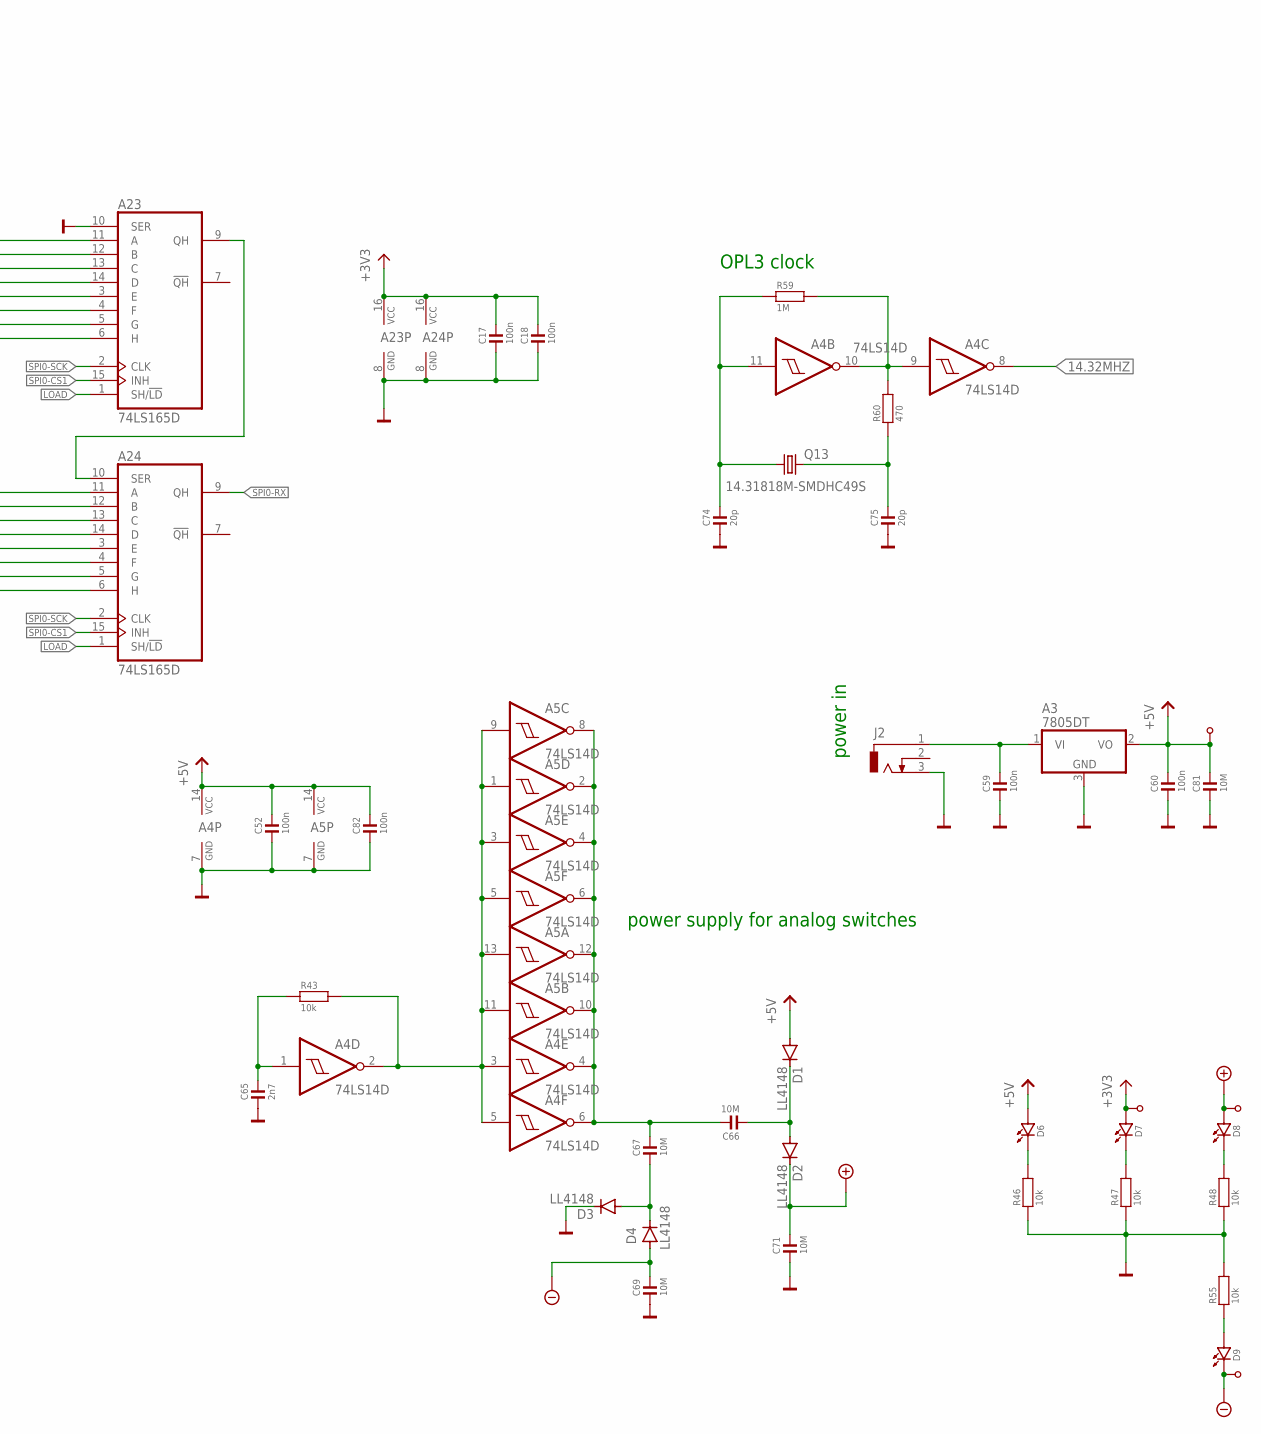
[picture p12: schematic SVCSYNTH00.sch, sheet 1, part in row 1, column 2]

Parts:
A3: 7805DT; TO252
A4, A5: 74LS14D; SO14
A23, A24: 74LS165D; SO16
C1, C2, C3, C4, C5, C6, C7, C8, C9, C10, C11, C12, C13, C14, C15, C16, C65: 2n7; R0805
C17, C18, C52, C59, C60, C82: 100n; R0805
C66, C67, C69, C71, C81: 10M; R1206
C74, C75: 20p; R0805
D1, D2, D3, D4: LL4148; SOD80C
D6, D7, D8, D9: LED3MM
J2: DCJ0303
K1, K2, K3, K4: K1_0.9_1.8; K_0.9_1.8
Q13: 14.31818M-SMDHC49S; CSM-7X-DU
R1, R2, R3, R4, R5, R6, R7, R8, R9, R10, R11, R12, R13, R14, R15, R16, R43, R46, R47, R48, R55: 10k; R0805
R59: 1M; R0805
R60: 470; R0805
S1, S2, S3, S4, S5, S6, S7, S8, S9, S10, S11, S12, S13, S14, S15, S16: 101-TS6211T1603-EV; 101TS6211T1603EV

Connections:
14.32MHZ: A4.8 (O); also elsewhere on the board
+3V3: A23.16 (VCC), A24.16 (VCC), C17.2, C18.2, D7.A, K4.1, R1.1 (2), R2.1 (2), R3.1 (2), R4.1 (2), R5.1 (2), R6.1 (2), R7.1 (2), R8.1 (2), R9.1 (2), R10.1 (2), R11.1 (2), R12.1 (2), R13.1 (2), R14.1 (2), R15.1 (2), R16.1 (2); also elsewhere on the board
+5V: A3.2 (VO), A4.14 (VCC), A5.14 (VCC), C52.2, C60.2, C81.2, C82.2, D1.A, D6.A, K1.1; also elsewhere on the board
+9V: C71.2, D2.C, D8.A, K2.1; also elsewhere on the board
-5V: C69.2, D4.A, D9.K (C), K3.1; also elsewhere on the board
GND: A3.3 (GND), A4.7 (GND), A5.7 (GND), A23.8 (GND), A23.10 (SER), A24.8 (GND), C1.1, C2.1, C3.1, C4.1, C5.1, C6.1, C7.1, C8.1, C9.1, C10.1, C11.1, C12.1, C13.1, C14.1, C15.1, C16.1, C17.1, C18.1, C52.1, C59.1, C60.1, C65.1, C69.1, C71.1, C74.1, C75.1, C81.1, C82.1, D3.C, J2.3, R46.2 (1), R47.2 (1), R48.2 (1), R55.1 (2), S1.T3 (NO1), S2.T3 (NO1), S3.T3 (NO1), S4.T3 (NO1), S5.T3 (NO1), S6.T3 (NO1), S7.T3 (NO1), S8.T3 (NO1), S9.T3 (NO1), S10.T3 (NO1), S11.T3 (NO1), S12.T3 (NO1), S13.T3 (NO1), S14.T3 (NO1), S15.T3 (NO1), S16.T3 (NO1); also elsewhere on the board
LOAD: A23.1 (SH/!LD), A24.1 (SH/!LD); also elsewhere on the board
unnamed: A4.11 (I), C74.2, Q13.1, R59.2 (1)
unnamed: C75.2, Q13.2, R60.2 (1)
unnamed: A4.9 (I), A4.10 (O), R59.1 (2), R60.1 (2)
unnamed: A4.1 (I), C65.2, R43.2 (1)
unnamed: A4.2 (O), A4.3 (I), A4.5 (I), A5.1 (I), A5.3 (I), A5.5 (I), A5.9 (I), A5.11 (I), A5.13 (I), R43.1 (2)
unnamed: A4.4 (O), A4.6 (O), A5.2 (O), A5.4 (O), A5.6 (O), A5.8 (O), A5.10 (O), A5.12 (O), C66.2, C67.2
unnamed: C67.1, D3.A, D4.C
unnamed: C66.1, D1.C, D2.A
unnamed: A23.11 (A), C1.2, R1.2 (1), S1.T2 (COM2)
unnamed: A23.9 (QH), A24.10 (SER)
unnamed: A23.12 (B), C2.2, R2.2 (1), S2.T2 (COM2)
unnamed: A23.13 (C), C3.2, R3.2 (1), S3.T2 (COM2)
unnamed: A23.14 (D), C4.2, R4.2 (1), S4.T2 (COM2)
unnamed: A24.11 (A), C9.2, R9.2 (1), S9.T2 (COM2)
unnamed: A24.12 (B), C10.2, R10.2 (1), S10.T2 (COM2)
unnamed: A24.13 (C), C11.2, R11.2 (1), S11.T2 (COM2)
unnamed: A24.14 (D), C12.2, R12.2 (1), S12.T2 (COM2)
unnamed: A23.6 (H), C5.2, R5.2 (1), S5.T2 (COM2)
unnamed: A23.5 (G), C6.2, R6.2 (1), S6.T2 (COM2)
unnamed: A23.4 (F), C7.2, R7.2 (1), S7.T2 (COM2)
unnamed: A23.3 (E), C8.2, R8.2 (1), S8.T2 (COM2)
unnamed: A24.6 (H), C13.2, R13.2 (1), S13.T2 (COM2)
unnamed: A24.5 (G), C14.2, R14.2 (1), S14.T2 (COM2)
unnamed: A24.4 (F), C15.2, R15.2 (1), S15.T2 (COM2)
unnamed: A24.3 (E), C16.2, R16.2 (1), S16.T2 (COM2)
unnamed: A3.1 (VI), C59.2, J2.1
unnamed: D6.K (C), R46.1 (2)
unnamed: D7.K (C), R47.1 (2)
unnamed: D8.K (C), R48.1 (2)
unnamed: D9.A, R55.2 (1)
SPI0-CS1: A23.15 (INH), A24.15 (INH); also elsewhere on the board
SPI0-RX: A24.9 (QH); also elsewhere on the board
SPI0-SCK: A23.2 (CLK), A24.2 (CLK); also elsewhere on the board

Notes on the sheet:
RC = 27ms
digital inputs, thru shift register via SPI1
OPL3 clock
power supply for analog switches
power in

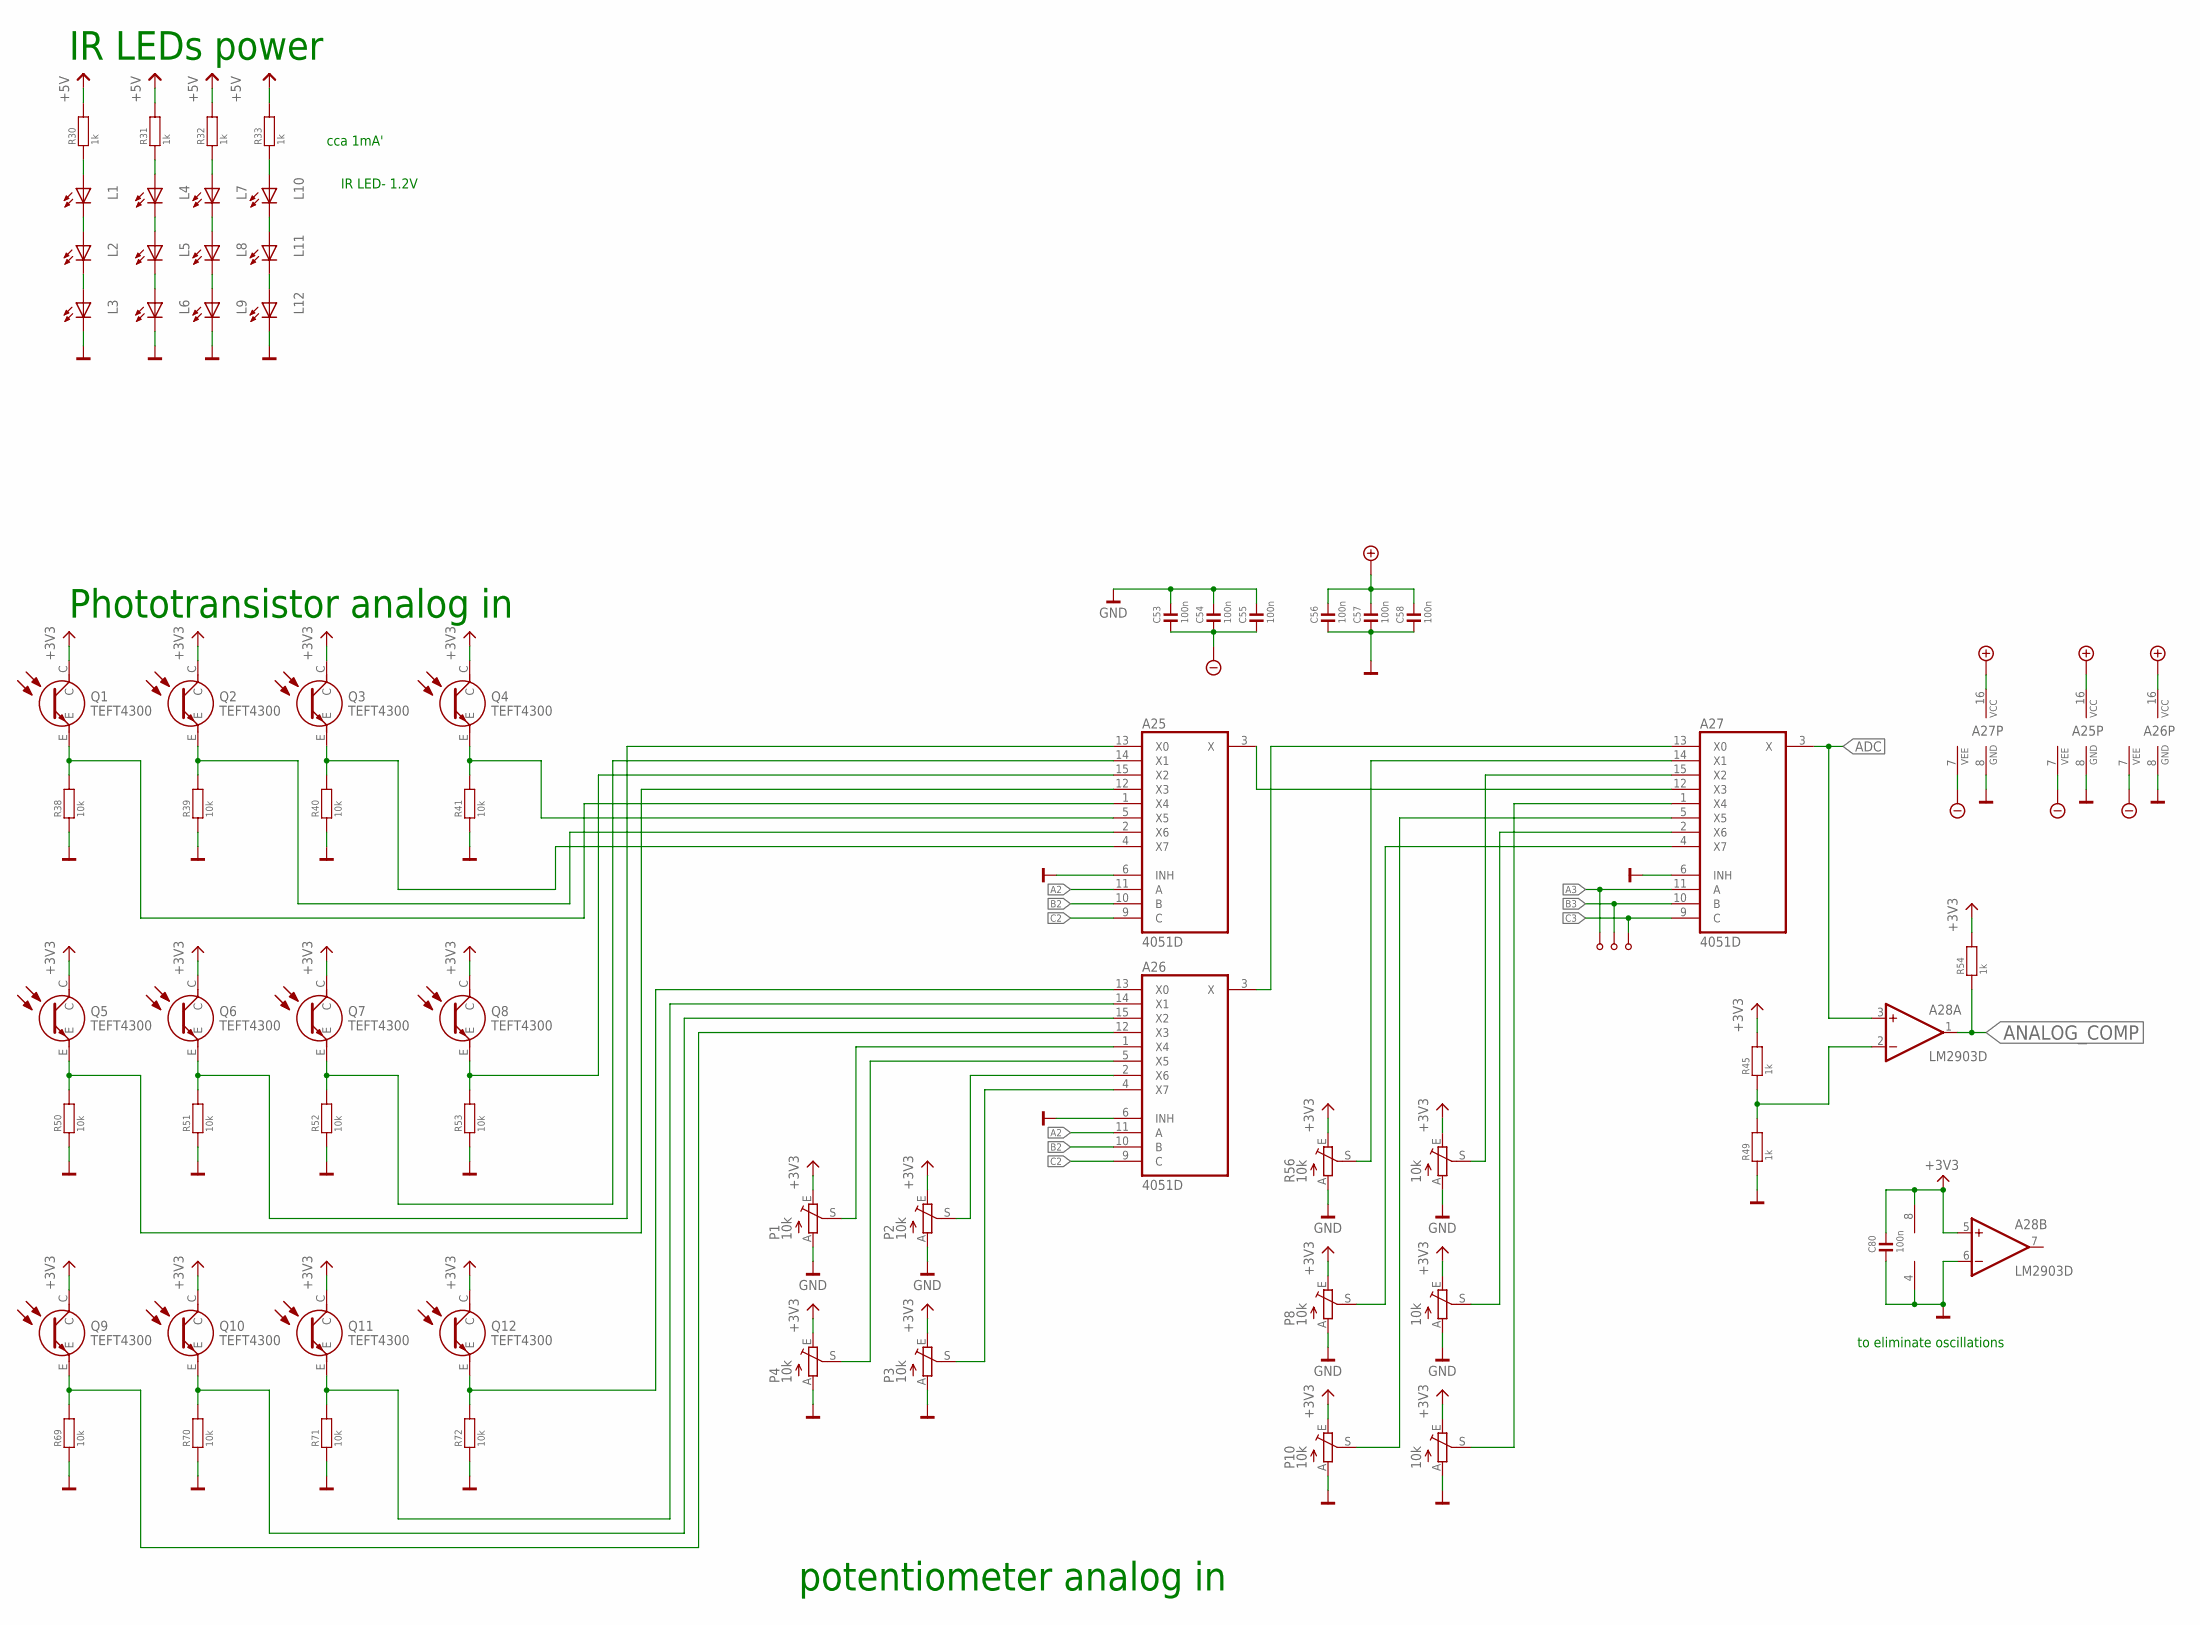
[picture p13: schematic SVCSYNTH00.sch, sheet 2]

Parts:
A25, A26, A27: 4051D; SO16
A28: LM2903D; SO08
C53, C54, C55, C56, C57, C58, C80: 100n; R0805
K8, K9, K10: K1_0.8_1.6; K_0.8_1.6
L1, L2, L3, L4, L5, L6, L7, L8, L9, L10, L11, L12: LED3MM
P1, P2, P3, P4, P6, P8, P10: 10k; CA6V
Q1, Q2, Q3, Q4, Q5, Q6, Q7, Q8, Q9, Q10, Q11, Q12: TEFT4300
R30, R31, R32, R33, R45, R49, R54: 1k; R0805
R38, R39, R40, R41, R50, R51, R52, R53, R69, R70, R71, R72: 10k; R0805
R56, R57, R74: 10k; CA6V

Connections:
+3V3: A28.5 (+IN), A28.8 (V+), C80.2, P1.E, P2.E, P3.E, P4.E, P6.E, P8.E, P10.E, Q1.C, Q2.C, Q3.C, Q4.C, Q5.C, Q6.C, Q7.C, Q8.C, Q9.C, Q10.C, Q11.C, Q12.C, R45.1 (2), R54.1 (2), R56.E, R57.E, R74.E; also elsewhere on the board
+5V: R30.1 (2), R31.1 (2), R32.1 (2), R33.1 (2); also elsewhere on the board
+9V: A25.16 (VCC), A26.16 (VCC), A27.16 (VCC), C56.2, C57.2, C58.2; also elsewhere on the board
-5V: A25.7 (VEE), A26.7 (VEE), A27.7 (VEE), C53.1, C54.1, C55.1; also elsewhere on the board
A2: A25.11 (A), A26.11 (A); also elsewhere on the board
A3: A27.11 (A), K8.1; also elsewhere on the board
ADC: A27.3 (X), A28.3 (+IN); also elsewhere on the board
ANALOG_COMP: A28.1 (OUT), R54.2 (1); also elsewhere on the board
B2: A25.10 (B), A26.10 (B); also elsewhere on the board
B3: A27.10 (B), K9.1; also elsewhere on the board
C2: A25.9 (C), A26.9 (C); also elsewhere on the board
C3: A27.9 (C), K10.1; also elsewhere on the board
GND: A25.6 (INH), A25.8 (GND), A26.6 (INH), A26.8 (GND), A27.6 (INH), A27.8 (GND), A28.4 (V-), A28.6 (-IN), C53.2, C54.2, C55.2, C56.1, C57.1, C58.1, C80.1, L3.K (C), L6.K (C), L9.K (C), L12.K (C), P1.A, P2.A, P3.A, P4.A, P6.A, P8.A, P10.A, R38.2 (1), R39.2 (1), R40.2 (1), R41.2 (1), R49.2 (1), R50.2 (1), R51.2 (1), R52.2 (1), R53.2 (1), R56.A, R57.A, R69.2 (1), R70.2 (1), R71.2 (1), R72.2 (1), R74.A; also elsewhere on the board
unnamed: A25.3 (X), A27.12 (X3)
unnamed: A26.3 (X), A27.13 (X0)
unnamed: A27.14 (X1), R56.S
unnamed: A27.4 (X7), P8.S
unnamed: A27.5 (X5), P10.S
unnamed: A27.15 (X2), R57.S
unnamed: L1.A, R30.2 (1)
unnamed: L1.K (C), L2.A
unnamed: L2.K (C), L3.A
unnamed: A25.5 (X5), Q4.E, R41.1 (2)
unnamed: L5.K (C), L6.A
unnamed: L4.K (C), L5.A
unnamed: L4.A, R31.2 (1)
unnamed: L7.A, R32.2 (1)
unnamed: L7.K (C), L8.A
unnamed: L8.K (C), L9.A
unnamed: L11.K (C), L12.A
unnamed: L10.K (C), L11.A
unnamed: A25.4 (X7), Q3.E, R40.1 (2)
unnamed: A25.2 (X6), Q2.E, R39.1 (2)
unnamed: A25.1 (X4), Q1.E, R38.1 (2)
unnamed: A25.15 (X2), Q8.E, R53.1 (2)
unnamed: A25.14 (X1), Q7.E, R52.1 (2)
unnamed: A25.13 (X0), Q6.E, R51.1 (2)
unnamed: A25.12 (X3), Q5.E, R50.1 (2)
unnamed: A26.13 (X0), Q12.E, R72.1 (2)
unnamed: A26.14 (X1), Q11.E, R71.1 (2)
unnamed: A26.15 (X2), Q10.E, R70.1 (2)
unnamed: A26.12 (X3), Q9.E, R69.1 (2)
unnamed: A26.1 (X4), P1.S
unnamed: A26.5 (X5), P4.S
unnamed: A26.2 (X6), P2.S
unnamed: A26.4 (X7), P3.S
unnamed: A27.2 (X6), P6.S
unnamed: A27.1 (X4), R74.S
unnamed: A28.2 (-IN), R45.2 (1), R49.1 (2)
unnamed: L10.A, R33.2 (1)

Notes on the sheet:
Phototransistor analog in
potentiometer analog in
to eliminate oscillations
IR LED- 1.2V
cca 1mA'
IR LEDs power

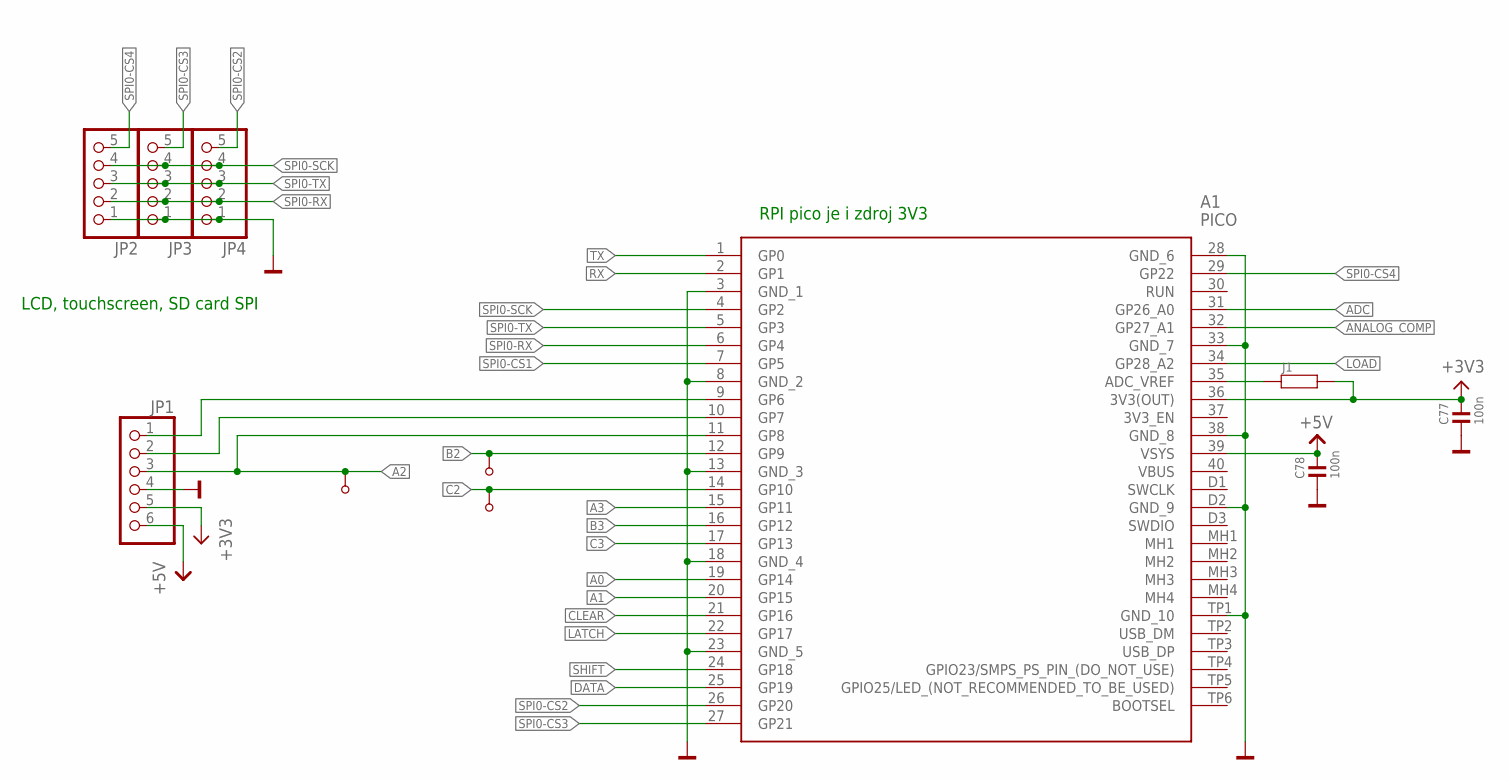
[picture p14: schematic SVCSYNTH00.sch, sheet 3]

Parts:
A1: PICO
C77, C78: 100n; R0805
J1: R0402
JP1: PINHD-1X6; 1X06
JP2, JP3, JP4: PINHD-1X5; 1X05
K5, K6, K7: K1_1.0_2.2; K_1.0_2.2

Connections:
+3V3: A1.36 (3V3(OUT)), C77.2, J1.2, JP1.5; also elsewhere on the board
+5V: A1.39 (VSYS), C78.2, JP1.6; also elsewhere on the board
A0: A1.19 (GP14); also elsewhere on the board
A1: A1.20 (GP15); also elsewhere on the board
A2: A1.11 (GP8), JP1.3, K5.1; also elsewhere on the board
A3: A1.15 (GP11); also elsewhere on the board
ADC: A1.31 (GP26_A0); also elsewhere on the board
ANALOG_COMP: A1.32 (GP27_A1); also elsewhere on the board
B2: A1.12 (GP9), K7.1; also elsewhere on the board
B3: A1.16 (GP12); also elsewhere on the board
C2: A1.14 (GP10), K6.1; also elsewhere on the board
C3: A1.17 (GP13); also elsewhere on the board
CLEAR: A1.21 (GP16); also elsewhere on the board
DATA: A1.25 (GP19); also elsewhere on the board
GND: A1.3 (GND_1), A1.8 (GND_2), A1.13 (GND_3), A1.18 (GND_4), A1.23 (GND_5), A1.28 (GND_6), A1.33 (GND_7), A1.38 (GND_8), A1.D2 (GND_9), A1.TP1 (GND_10), C77.1, C78.1, JP1.4, JP2.1, JP3.1, JP4.1; also elsewhere on the board
LATCH: A1.22 (GP17); also elsewhere on the board
LOAD: A1.34 (GP28_A2); also elsewhere on the board
unnamed: A1.35 (ADC_VREF), J1.1
unnamed: A1.9 (GP6), JP1.1
unnamed: A1.10 (GP7), JP1.2
RX: A1.2 (GP1); also elsewhere on the board
SHIFT: A1.24 (GP18); also elsewhere on the board
SPI0-CS1: A1.7 (GP5); also elsewhere on the board
SPI0-CS2: A1.26 (GP20), JP4.5
SPI0-CS3: A1.27 (GP21), JP3.5
SPI0-CS4: A1.29 (GP22), JP2.5
SPI0-RX: A1.6 (GP4), JP2.2, JP3.2, JP4.2; also elsewhere on the board
SPI0-SCK: A1.4 (GP2), JP2.4, JP3.4, JP4.4; also elsewhere on the board
SPI0-TX: A1.5 (GP3), JP2.3, JP3.3, JP4.3
TX: A1.1 (GP0); also elsewhere on the board

Notes on the sheet:
LCD, touchscreen, SD card SPI
RPI pico je i zdroj 3V3

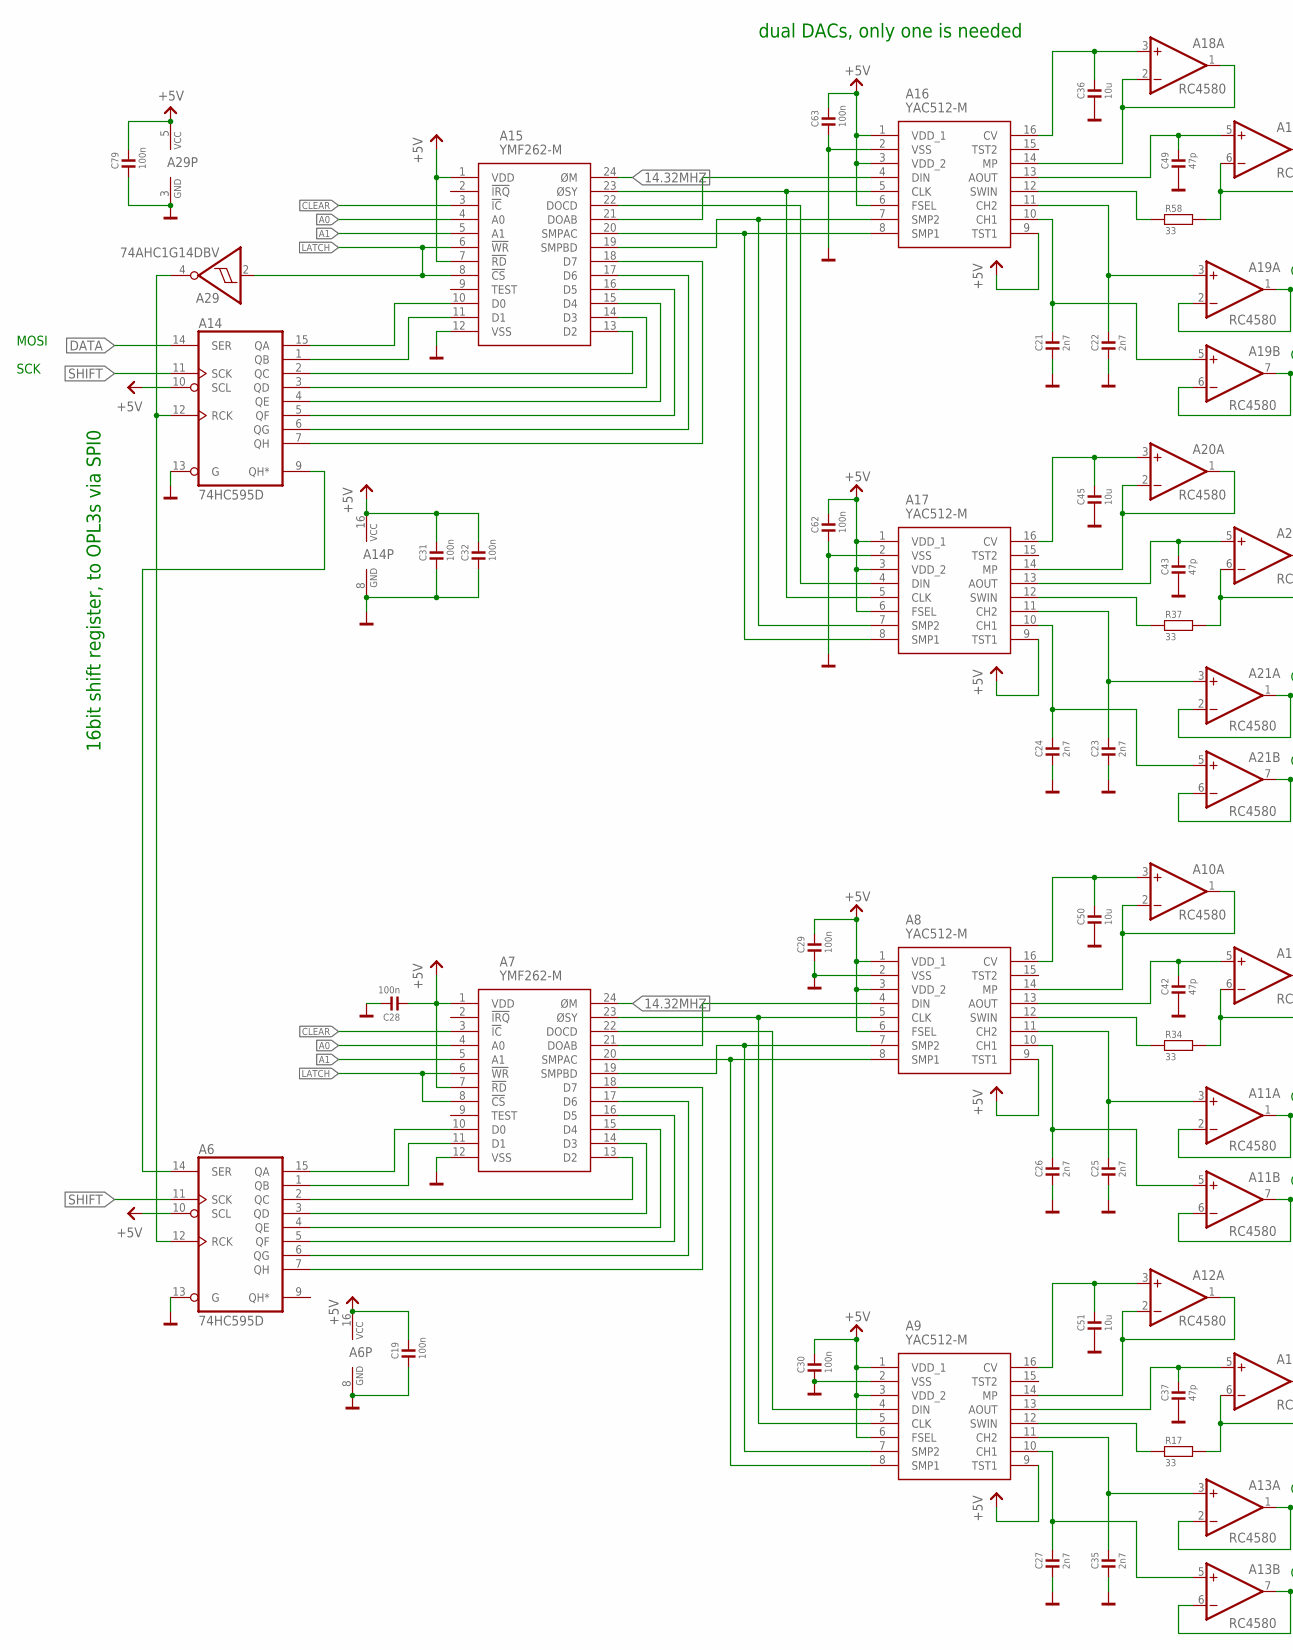
[picture p15: schematic SVCSYNTH00.sch, sheet 4, part in row 1, column 1]

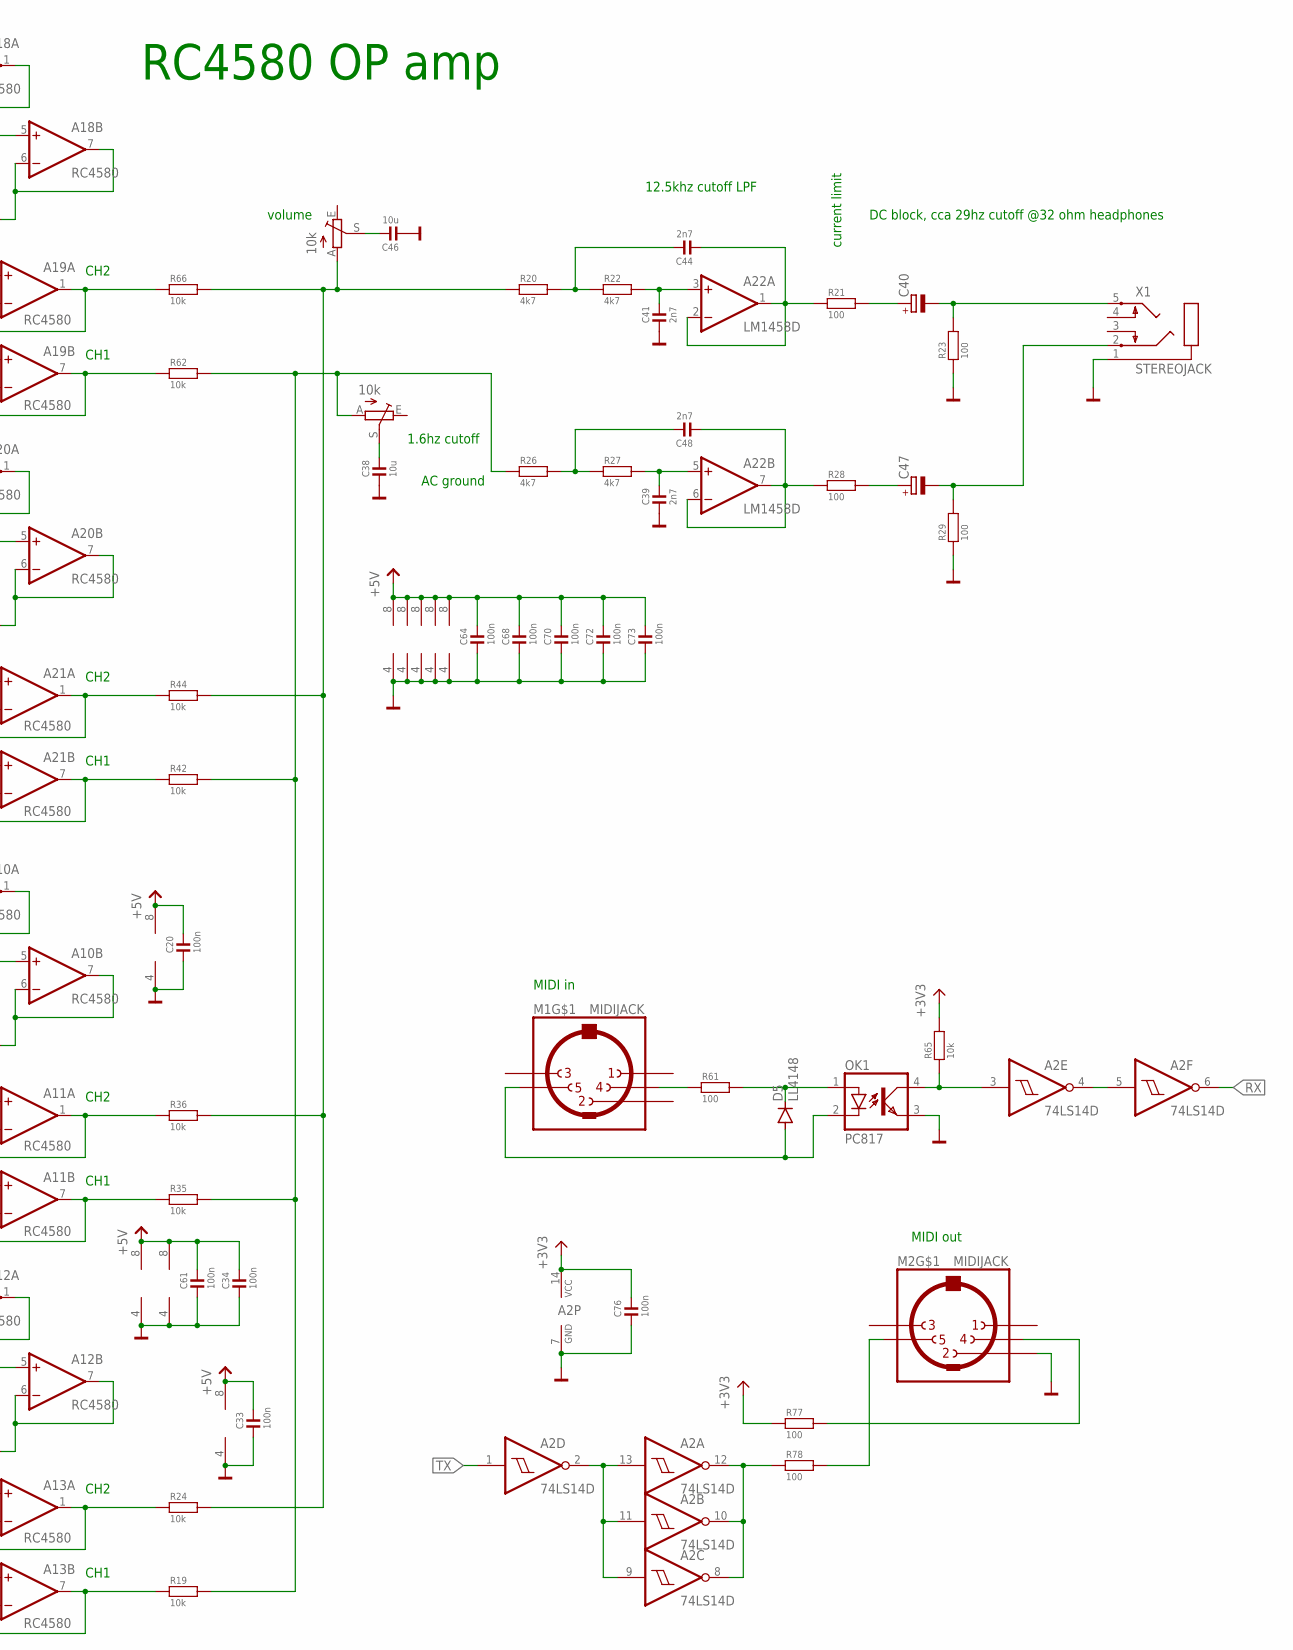
[picture p16: schematic SVCSYNTH00.sch, sheet 4, part in row 1, column 2]

Parts:
A2: 74LS14D; SO14
A6, A14: 74HC595D; SO16
A7, A15: YMF262-M; SOIC127P1180X250-24N
A8, A9, A16, A17: YAC512-M; SOIC127P780X230-16N
A10, A11, A12, A13, A18, A19, A20, A21: RC4580; SO08
A22: LM1458D; SO08
A29: 74AHC1G14DBV; SOT23-5
C19, C20, C28, C29, C30, C31, C32, C33, C34, C61, C62, C63, C64, C68, C70, C72, C73, C76, C79: 100n; R0805
C21, C22, C23, C24, C25, C26, C27, C35, C39, C41, C44, C48: 2n7; R0805
C36, C38, C45, C46, C50, C51: 10u; R0805
C37, C42, C43, C49: 47p; R0805
C40, C47: CPOL-EUE3.5-8; E3,5-8
D5: LL4148; SOD80C
M1, M2: MIDIJACK; CP-2350
OK1: PC817; DIL04
R17, R34, R37, R58: 33; R0805
R18, R25: 10k; CA6V
R19, R24, R35, R36, R42, R44, R62, R65, R66: 10k; R0805
R20, R22, R26, R27: 4k7; R0805
R21, R23, R28, R29, R61, R77, R78: 100; R0805
X1: STEREOJACK; STX3100

Connections:
14.32MHZ: A7.24 (ØM), A15.24 (ØM); also elsewhere on the board
+3V3: A2.14 (VCC), C76.2, R65.1 (2), R77.2 (1); also elsewhere on the board
+5V: A6.10 (SCL), A6.16 (VCC), A7.1 (VDD), A7.7 (!RD), A8.1 (VDD_1), A8.3 (VDD_2), A8.6 (FSEL), A8.9 (TST1), A9.1 (VDD_1), A9.3 (VDD_2), A9.6 (FSEL), A9.9 (TST1), A10.8 (V+), A11.8 (V+), A12.8 (V+), A13.8 (V+), A14.10 (SCL), A14.16 (VCC), A15.1 (VDD), A15.7 (!RD), A16.1 (VDD_1), A16.3 (VDD_2), A16.6 (FSEL), A16.9 (TST1), A17.1 (VDD_1), A17.3 (VDD_2), A17.6 (FSEL), A17.9 (TST1), A18.8 (V+), A19.8 (V+), A20.8 (V+), A21.8 (V+), A22.8 (V+), A29.5 (VCC), C19.2, C20.2, C28.1, C29.2, C30.2, C31.2, C32.2, C33.2, C34.2, C61.2, C62.2, C63.2, C64.2, C68.2, C70.2, C72.2, C73.2, C79.2; also elsewhere on the board
A0: A7.4 (A0), A15.4 (A0); also elsewhere on the board
A1: A7.5 (A1), A15.5 (A1); also elsewhere on the board
CLEAR: A7.3 (!IC), A15.3 (!IC); also elsewhere on the board
DATA: A14.14 (SER); also elsewhere on the board
GND: A2.7 (GND), A6.8 (GND), A6.13 (G), A7.12 (VSS), A8.2 (VSS), A9.2 (VSS), A10.4 (V-), A11.4 (V-), A12.4 (V-), A13.4 (V-), A14.8 (GND), A14.13 (G), A15.12 (VSS), A16.2 (VSS), A17.2 (VSS), A18.4 (V-), A19.4 (V-), A20.4 (V-), A21.4 (V-), A22.4 (V-), A29.3 (GND), C19.1, C20.1, C21.1, C22.1, C23.1, C24.1, C25.1, C26.1, C27.1, C28.2, C29.1, C30.1, C31.1, C32.1, C33.1, C34.1, C35.1, C36.1, C37.1, C38.1, C39.1, C41.1, C42.1, C43.1, C45.1, C46.1, C49.1, C50.1, C51.1, C61.1, C62.1, C63.1, C64.1, C68.1, C70.1, C72.1, C73.1, C76.1, C79.1, M2.2, OK1.3 (EMIT), R23.2 (1), R29.2 (1), X1.1; also elsewhere on the board
LATCH: A7.6 (!WR), A7.8 (!CS), A15.6 (!WR), A15.8 (!CS), A29.2 (I); also elsewhere on the board
unnamed: A16.13 (AOUT), A18.5 (+IN), C49.2
unnamed: A16.14 (MP), A18.1 (OUT), A18.2 (-IN)
unnamed: A16.16 (CV), A18.3 (+IN), C36.2
unnamed: A18.6 (-IN), A18.7 (OUT), R58.1 (2)
unnamed: A16.12 (SWIN), R58.2 (1)
unnamed: A16.10 (CH1), A19.5 (+IN), C21.2
unnamed: A16.11 (CH2), A19.3 (+IN), C22.2
unnamed: A19.1 (OUT), A19.2 (-IN), R66.2 (1)
unnamed: A19.6 (-IN), A19.7 (OUT), R62.2 (1)
unnamed: A14.15 (QA), A15.10 (D0)
unnamed: A14.1 (QB), A15.11 (D1)
unnamed: A14.2 (QC), A15.13 (D2)
unnamed: A14.3 (QD), A15.14 (D3)
unnamed: A14.4 (QE), A15.15 (D4)
unnamed: A14.5 (QF), A15.16 (D5)
unnamed: A14.6 (QG), A15.17 (D6)
unnamed: A14.7 (QH), A15.18 (D7)
unnamed: A15.20 (SMPAC), A16.8 (SMP1), A17.8 (SMP1)
unnamed: A8.14 (MP), A10.1 (OUT), A10.2 (-IN)
unnamed: A15.21 (DOAB), A16.4 (DIN)
unnamed: A15.23 (ØSY), A16.5 (CLK), A17.5 (CLK)
unnamed: A17.14 (MP), A20.1 (OUT), A20.2 (-IN)
unnamed: A6.12 (RCK), A14.12 (RCK), A29.4 (O)
unnamed: A17.16 (CV), A20.3 (+IN), C45.2
unnamed: A17.13 (AOUT), A20.5 (+IN), C43.2
unnamed: A20.6 (-IN), A20.7 (OUT), R37.1 (2)
unnamed: A17.12 (SWIN), R37.2 (1)
unnamed: A17.10 (CH1), A21.5 (+IN), C24.2
unnamed: A17.11 (CH2), A21.3 (+IN), C23.2
unnamed: A21.1 (OUT), A21.2 (-IN), R44.2 (1)
unnamed: A21.6 (-IN), A21.7 (OUT), R42.2 (1)
unnamed: A15.19 (SMPBD), A16.7 (SMP2), A17.7 (SMP2)
unnamed: A15.22 (DOCD), A17.4 (DIN)
unnamed: A8.16 (CV), A10.3 (+IN), C50.2
unnamed: A8.13 (AOUT), A10.5 (+IN), C42.2
unnamed: A10.6 (-IN), A10.7 (OUT), R34.1 (2)
unnamed: A8.12 (SWIN), R34.2 (1)
unnamed: A8.10 (CH1), A11.5 (+IN), C26.2
unnamed: A8.11 (CH2), A11.3 (+IN), C25.2
unnamed: A11.1 (OUT), A11.2 (-IN), R36.2 (1)
unnamed: A11.6 (-IN), A11.7 (OUT), R35.2 (1)
unnamed: A6.15 (QA), A7.10 (D0)
unnamed: A6.1 (QB), A7.11 (D1)
unnamed: A6.2 (QC), A7.13 (D2)
unnamed: A6.3 (QD), A7.14 (D3)
unnamed: A6.4 (QE), A7.15 (D4)
unnamed: A6.5 (QF), A7.16 (D5)
unnamed: A6.6 (QG), A7.17 (D6)
unnamed: A6.7 (QH), A7.18 (D7)
unnamed: A7.20 (SMPAC), A8.8 (SMP1), A9.8 (SMP1)
unnamed: A7.21 (DOAB), A8.4 (DIN)
unnamed: A7.23 (ØSY), A8.5 (CLK), A9.5 (CLK)
unnamed: A9.14 (MP), A12.1 (OUT), A12.2 (-IN)
unnamed: A9.16 (CV), A12.3 (+IN), C51.2
unnamed: A9.13 (AOUT), A12.5 (+IN), C37.2
unnamed: A12.6 (-IN), A12.7 (OUT), R17.1 (2)
unnamed: A9.12 (SWIN), R17.2 (1)
unnamed: A9.10 (CH1), A13.5 (+IN), C27.2
unnamed: A9.11 (CH2), A13.3 (+IN), C35.2
unnamed: A13.1 (OUT), A13.2 (-IN), R24.2 (1)
unnamed: A13.6 (-IN), A13.7 (OUT), R19.2 (1)
unnamed: A7.19 (SMPBD), A8.7 (SMP2), A9.7 (SMP2)
unnamed: A7.22 (DOCD), A9.4 (DIN)
unnamed: A6.14 (SER), A14.9 (QH*)
unnamed: A22.3 (+IN), C41.2, R22.1 (2)
unnamed: R19.1 (2), R25.A, R26.2 (1), R35.1 (2), R42.1 (2), R62.1 (2)
unnamed: C38.2, R25.S
unnamed: R18.A, R20.2 (1), R24.1 (2), R36.1 (2), R44.1 (2), R66.1 (2)
unnamed: C46.2, R18.S
unnamed: C44.2, R20.1 (2), R22.2 (1)
unnamed: A22.5 (+IN), C39.2, R27.1 (2)
unnamed: A22.1 (OUT), A22.2 (-IN), C44.1, R21.2 (1)
unnamed: C48.2, R26.1 (2), R27.2 (1)
unnamed: A22.6 (-IN), A22.7 (OUT), C48.1, R28.2 (1)
unnamed: C40.+, R21.1 (2)
unnamed: C40.-, R23.1 (2), X1.5
unnamed: C47.+, R28.1 (2)
unnamed: C47.-, R29.1 (2), X1.2
unnamed: A2.2 (O), A2.9 (I), A2.11 (I), A2.13 (I)
unnamed: A2.4 (O), A2.5 (I)
unnamed: M2.5, R78.1 (2)
unnamed: A2.8 (O), A2.10 (O), A2.12 (O), R78.2 (1)
unnamed: M1.4, R61.2 (1)
unnamed: M2.4, R77.1 (2)
unnamed: D5.A, M1.5, OK1.2 (C)
unnamed: D5.C, OK1.1 (A), R61.1 (2)
unnamed: A2.3 (I), OK1.4 (COL), R65.2 (1)
RX: A2.6 (O); also elsewhere on the board
SHIFT: A6.11 (SCK), A14.11 (SCK); also elsewhere on the board
TX: A2.1 (I); also elsewhere on the board

Notes on the sheet:
CH1
CH2
MOSI
SCK
16bit shift register, to OPL3s via SPI0
dual DACs, only one is needed
1.6hz cutoff
AC ground
12.5khz cutoff LPF
RC4580 OP amp
volume
current limit
DC block, cca 29hz cutoff @32 ohm headphones
MIDI out
MIDI in
