Jed0vcela/OPL-synth/schematics, board/opl3 synth EAGLE/SVCSYNTH00.brd

## EAGLE design schematics, board/opl3 synth EAGLE/SVCSYNTH00.brd (continued)

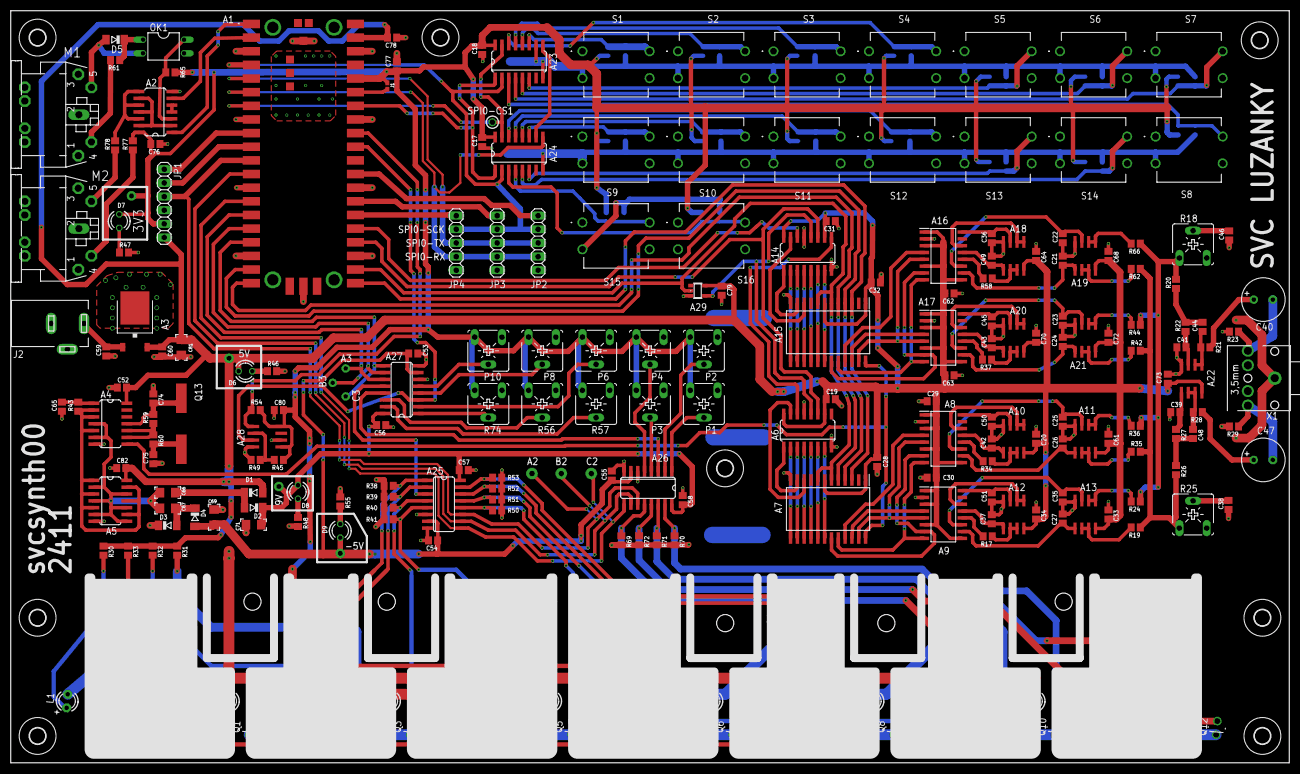
[picture p17: board SVCSYNTH00.brd from above]

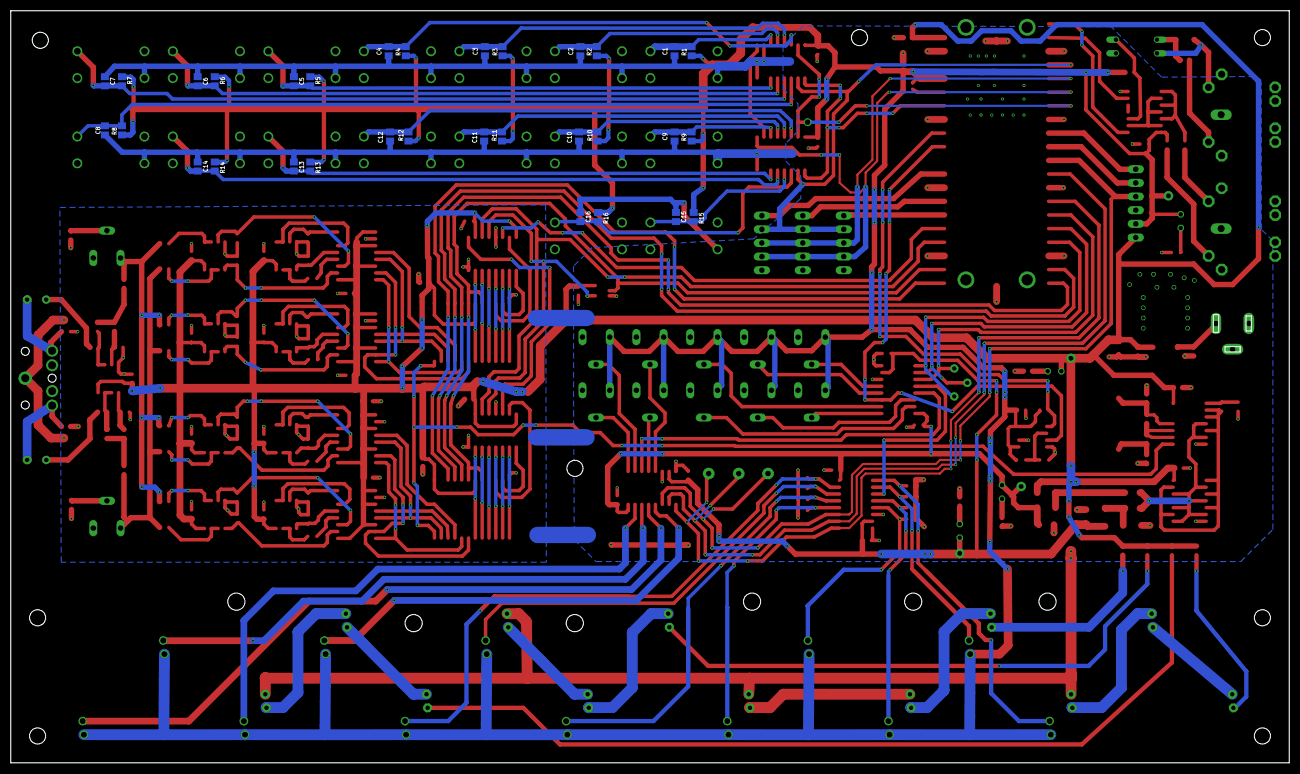
[picture p18: board SVCSYNTH00.brd from below]

Board: 2 copper layers, 238.0 x 140.0 mm, 267 parts (32 on the bottom side), 187 nets.

Other parts of the board:
U$8, U$10, U$11, U$13, U$14, U$15, U$17, U$18: 3,0
